KamilWuu/Line_Follower_ZACZ/README.md

# Line_Follower_ZACZ
LineFollower robot created with my friend Oliwier W. Robot is made as a project for a mobile robots course in the sixth semester of the automation and robotics program at the Wrocaw University of Science and Technology.
