KamilWuu/Line_Follower_ZACZ/zacz_QT/latex/mainwindow_8h.tex

\doxysection{/home/kamil/\+Documents/projects-\/repos/\+Line\+\_\+\+Follower\+\_\+\+ZACZ/zacz\+\_\+\+QT/mainwindow.h File Reference}
\hypertarget{mainwindow_8h}{}\label{mainwindow_8h}\index{/home/kamil/Documents/projects-\/repos/Line\_Follower\_ZACZ/zacz\_QT/mainwindow.h@{/home/kamil/Documents/projects-\/repos/Line\_Follower\_ZACZ/zacz\_QT/mainwindow.h}}

Plik nagłówkowy klasy \doxylink{classMainWindow}{Main\+Window}.  

{\ttfamily \#include $<$QMain\+Window$>$}\newline
{\ttfamily \#include $<$QDebug$>$}\newline
{\ttfamily \#include $<$QMessage\+Box$>$}\newline
{\ttfamily \#include $<$QString$>$}\newline
{\ttfamily \#include $<$QResize\+Event$>$}\newline
{\ttfamily \#include $<$QLabel$>$}\newline
{\ttfamily \#include $<$QList$>$}\newline
{\ttfamily \#include $<$QElapsed\+Timer$>$}\newline
{\ttfamily \#include $<$QTcp\+Socket$>$}\newline
{\ttfamily \#include $<$QTransform$>$}\newline
{\ttfamily \#include $<$QPixmap$>$}\newline
{\ttfamily \#include $<$QPainter$>$}\newline
{\ttfamily \#include $<$QPaint\+Event$>$}\newline
{\ttfamily \#include "{}plotwindow.\+h"{}}\newline
\doxysubsubsection*{Classes}
\begin{DoxyCompactItemize}
\item 
class \mbox{\hyperlink{classMainWindow}{Main\+Window}}
\begin{DoxyCompactList}\small\item\em Główne okno aplikacji. \end{DoxyCompactList}\end{DoxyCompactItemize}

\doxysubsection{Detailed Description}
Plik nagłówkowy klasy \doxylink{classMainWindow}{Main\+Window}.
