KamilWuu/Line_Follower_ZACZ/images/ae86.jpg

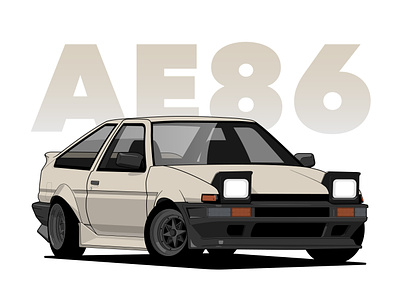
images/ae86.jpg
