KamilWuu/Line_Follower_ZACZ/images/ae862.jpg

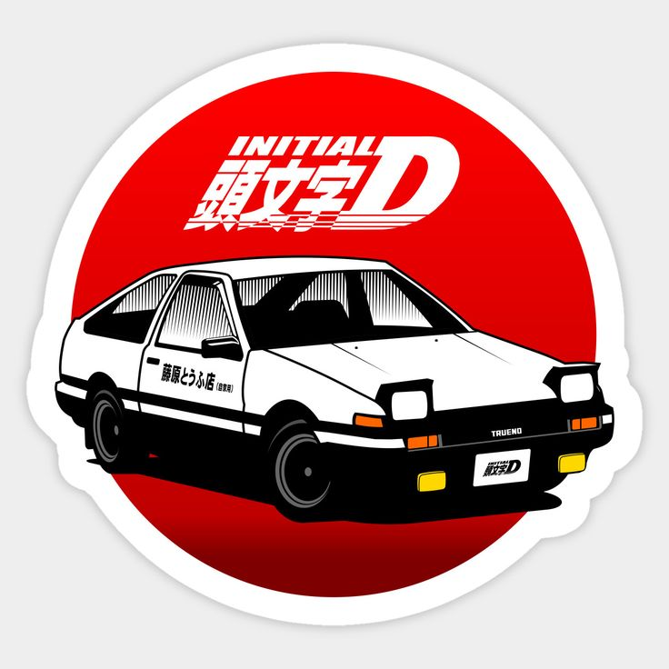
images/ae862.jpg
