KamilWuu/Line_Follower_ZACZ/images/ae863.jpg

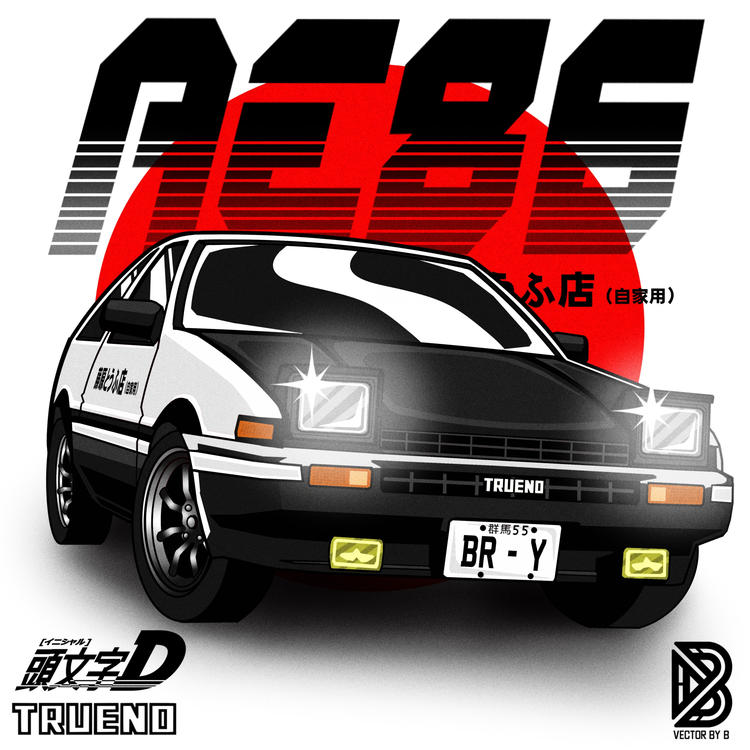
images/ae863.jpg
