KamilWuu/Line_Follower_ZACZ/zacz_QT/images/background.png

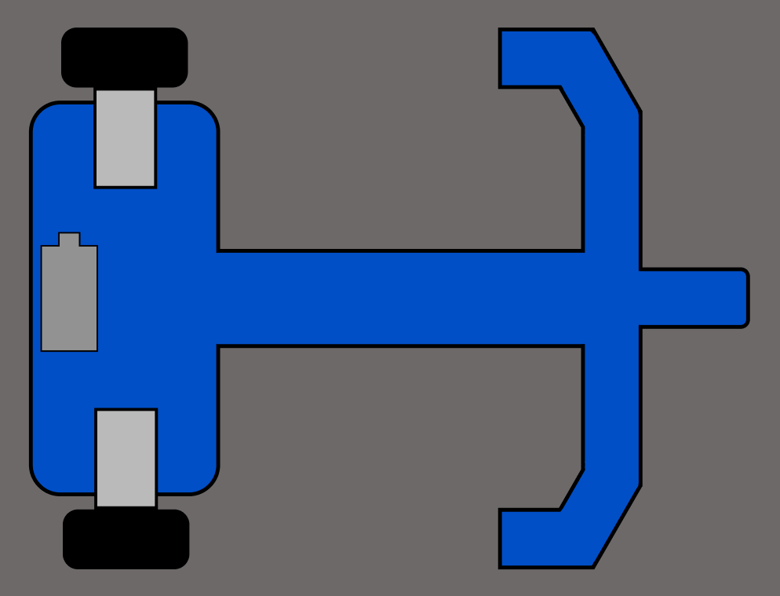
zacz_QT/images/background.png
