KamilWuu/Line_Follower_ZACZ/zacz_QT/images/kompas.png

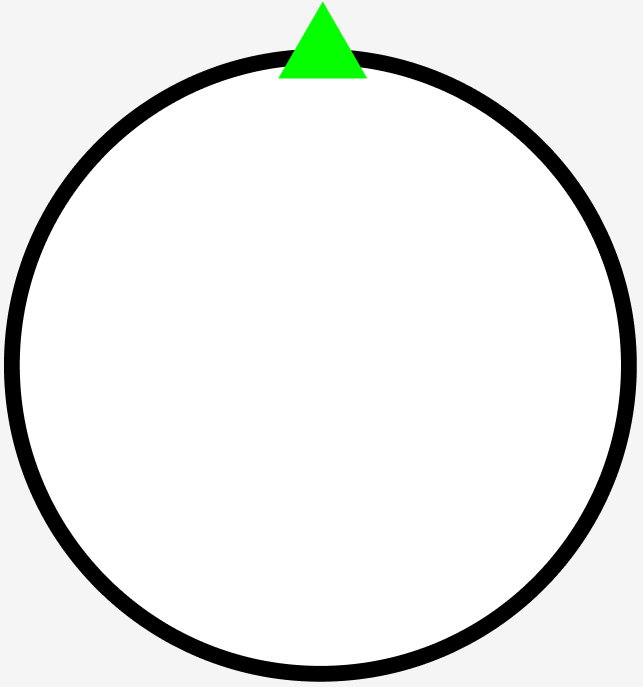
zacz_QT/images/kompas.png
