KamilWuu/Line_Follower_ZACZ/zacz_QT/images/main_background.png

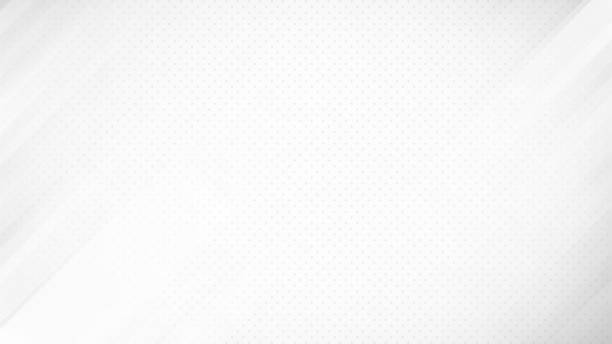
zacz_QT/images/main_background.png
