KamilWuu/Line_Follower_ZACZ/zacz_QT/images/robot_kompas.png

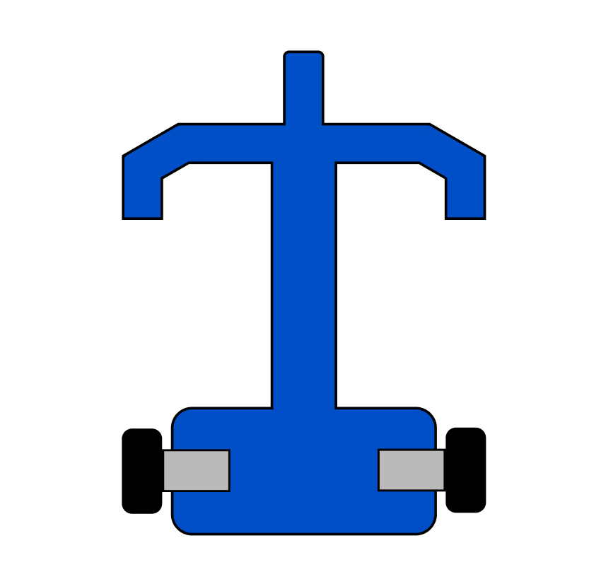
zacz_QT/images/robot_kompas.png
