KamilWuu/Line_Follower_ZACZ/images/main_board_v3.dxf

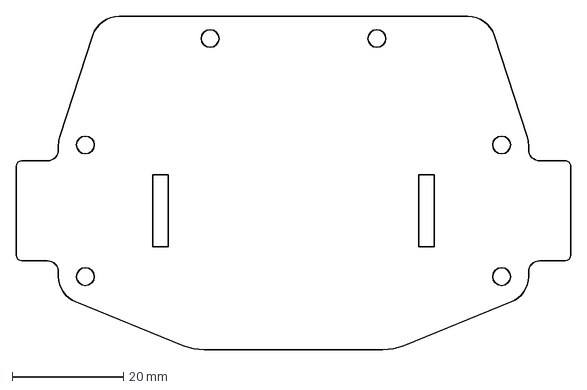
[picture p35: CAD file, 2024-04-28]
images/main_board_v3.dxf
99.8 x 60.0 mm
