KamilWuu/Line_Follower_ZACZ/images/main_board_limits.dxf

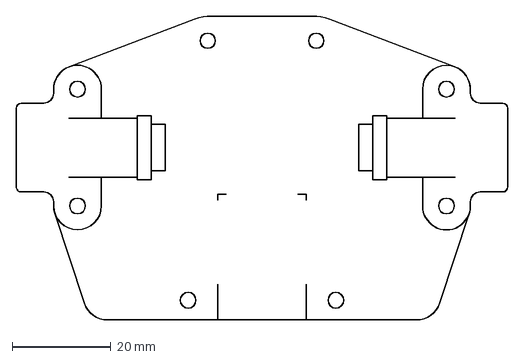
[picture p36: CAD file, 2024-04-28]
images/main_board_limits.dxf
99.8 x 61.7 mm
