KamilWuu/Line_Follower_ZACZ/mechanics/main_board.dxf

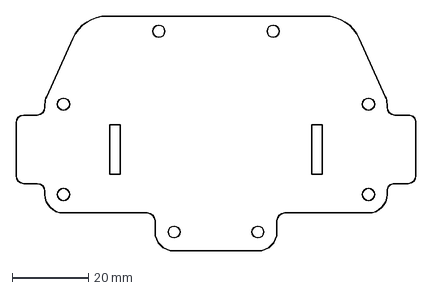
[picture p37: CAD file, 2024-04-23]
mechanics/main_board.dxf
105.0 x 61.7 mm
