KamilWuu/Line_Follower_ZACZ/electronics/Płytka główna/Płytka główna.step

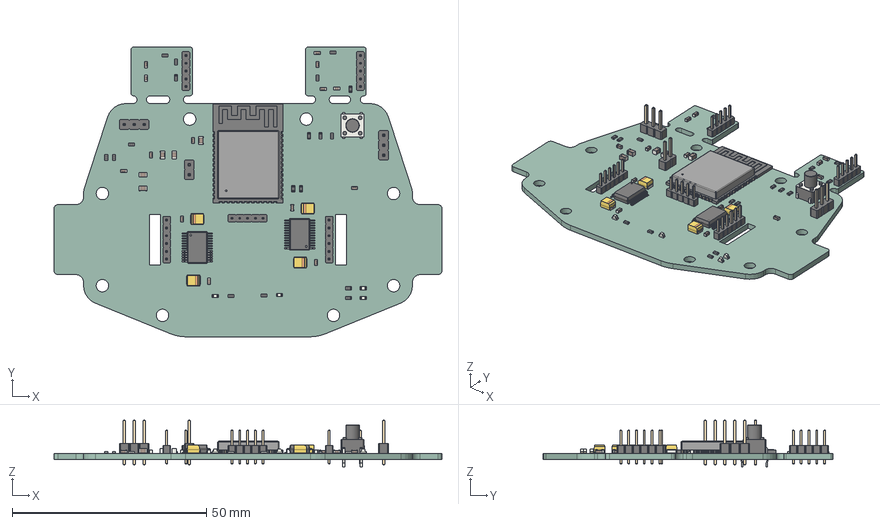
[picture p38: CAD file, 2024-06-22]
electronics/Płytka główna/Płytka główna.step
99.8 x 74.5 x 12.0 mm
LED_0603_1608Metric x 4
R_0603_1608Metric x 18
PinHeader_1x05_P200mm_Vertical x 3
ESP32-S3-WROOM-1
C_0603_1608Metric x 14
PinHeader_1x03_P254mm_Vertical x 2
CP_EIA_3528_21_Kemet_B x 4
C_0805_2012Metric x 5
PinHeader_1x06_P200mm_Vertical x 2
SSOP_24_53x82mm_P065mm x 2
PinHeader_1x02_P254mm_Vertical
SW_PUSH_6mm_h7.3mm
PÅytka gÅÃ³wna_PCB
