KamilWuu/Line_Follower_ZACZ/mechanics/Płytka z czujnikami.step

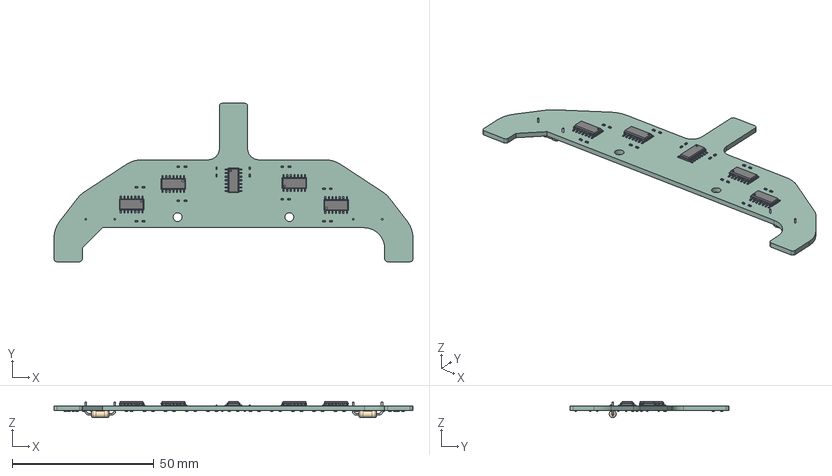
[picture p39: CAD file, 2024-06-22]
mechanics/Płytka z czujnikami.step
126.8 x 56.0 x 5.75 mm
R_0402_1005Metric x 60
CQ assembly x 5
R_Axial_DIN0207_L63mm_D25mm_P1016mm_Horizontal x 2
PÅytka z czujnikami_PCB
