KamilWuu/Line_Follower_ZACZ/images/plytka_glowna.dxf

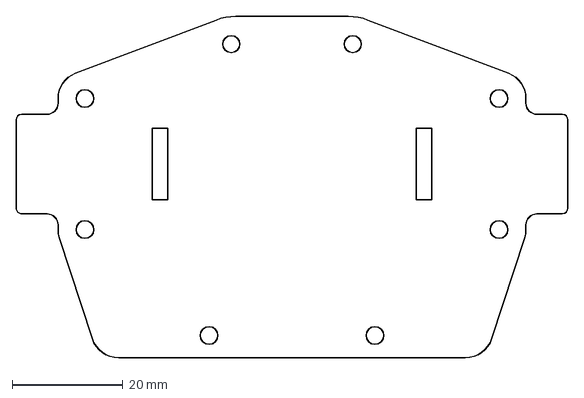
[picture p40: CAD file, 2024-04-24]
images/plytka_glowna.dxf
99.8 x 61.7 mm
