KamilWuu/Line_Follower_ZACZ/mechanics/sensor_board_V2.0.dxf

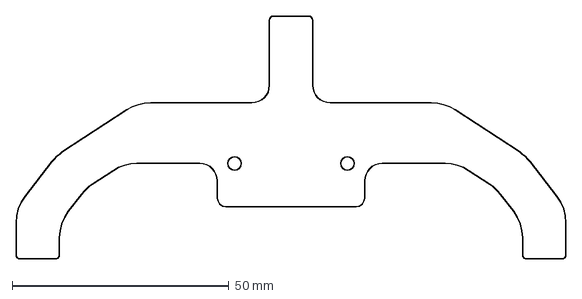
[picture p41: CAD file, 2024-04-29]
mechanics/sensor_board_V2.0.dxf
126.9 x 56.0 mm
