KamilWuu/Line_Follower_ZACZ/images/plytka_z_czujnikami.dxf

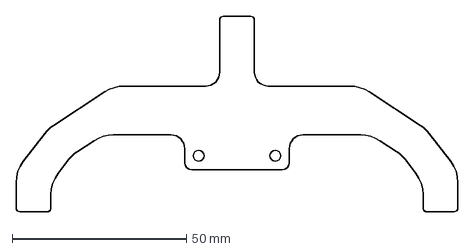
[picture p42: CAD file, 2024-04-24]
images/plytka_z_czujnikami.dxf
126.9 x 56.0 mm
