KamilWuu/Line_Follower_ZACZ/images/back_PCB_draw.dxf

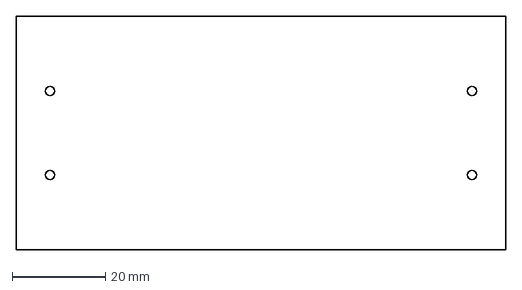
[picture p43: CAD file, 2024-03-31]
images/back_PCB_draw.dxf
105.0 x 50.0 mm
