KamilWuu/Line_Follower_ZACZ/mechanics/N20_Bracket_Extended_Pololu.stp

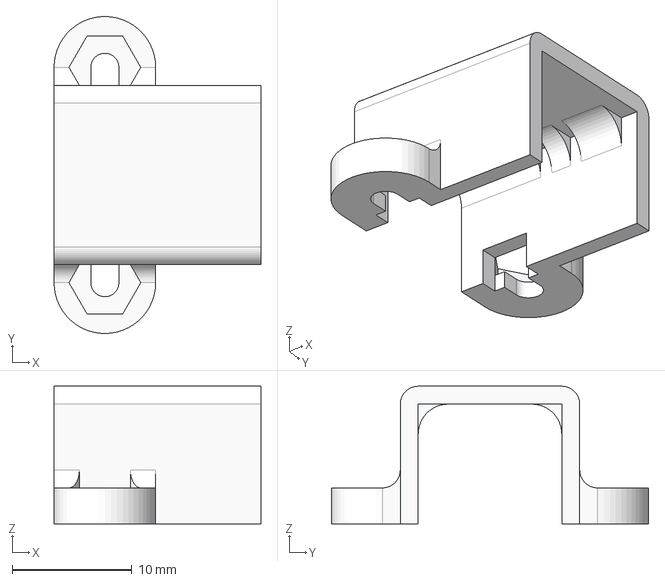
[picture p44: CAD file, 2024-04-23]
mechanics/N20_Bracket_Extended_Pololu.stp
17.3 x 26.5 x 11.5 mm
