KamilWuu/Line_Follower_ZACZ/mechanics/n20_bracket.step

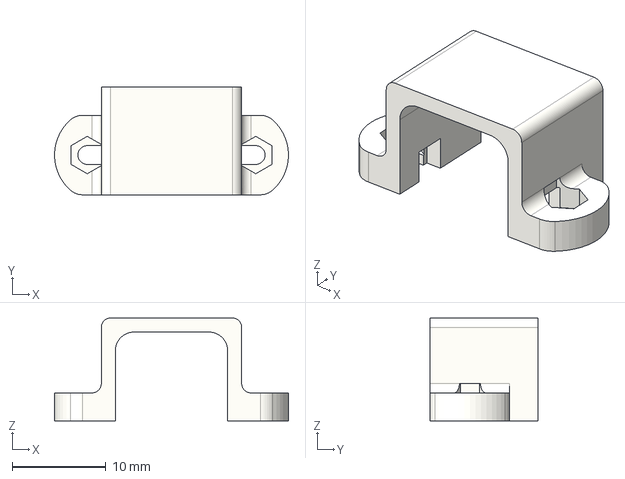
[picture p45: CAD file, 2024-03-31]
mechanics/n20_bracket.step
25.0 x 11.5 x 11.0 mm
