KamilWuu/Line_Follower_ZACZ/mechanics/sensor_board.dxf

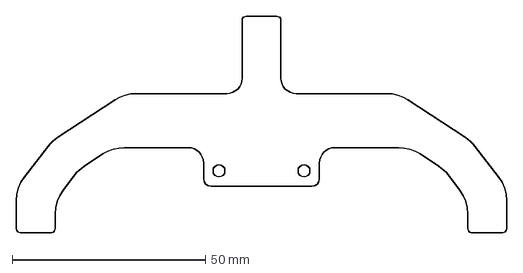
[picture p46: CAD file, 2024-04-27, an earlier design]
mechanics/sensor_board.dxf
126.9 x 56.0 mm
