KamilWuu/Line_Follower_ZACZ/(list of files, cad)

Other CAD files:
mechanics/Płytka główna.step
mechanics/A4.ipt
mechanics/ESP32-S3-WROOM-1.ipt
mechanics/LF.iam
mechanics/LF_2.iam
mechanics/N20_Bracket_Extended_Pololu.ipt
mechanics/OldVersions/LF_2.0014.iam
mechanics/OldVersions/N20_Bracket_Extended_Pololu.0002.ipt
mechanics/OldVersions/dol_trzymacz.0001.ipt
mechanics/OldVersions/lacznik.0005.ipt
mechanics/OldVersions/lacznik_2.0002.ipt
mechanics/OldVersions/li-pol_250.0001.ipt
mechanics/OldVersions/mocowanie.0001.ipt
mechanics/OldVersions/plytka_glowna.0005.ipt
mechanics/OldVersions/plytka_glowna_v3.0001.ipt
mechanics/OldVersions/przód V2.0.0001.ipt
mechanics/OldVersions/przód.0004.ipt
mechanics/OldVersions/ty.0006.ipt
mechanics/QRE1113GR.ipt
mechanics/belka.ipt
mechanics/dol_trzymacz.ipt
mechanics/kolko.ipt
mechanics/lacznik.ipt
mechanics/lacznik_2.ipt
mechanics/li-pol_250.ipt
mechanics/li-pol_520.ipt
mechanics/mocowanie.ipt
mechanics/n20_bracket.ipt
mechanics/plytka_glowna.ipt
mechanics/plytka_glowna_v3.ipt
mechanics/przód V2.0.ipt
mechanics/przód.ipt
mechanics/trzymacz.ipt
mechanics/ty.ipt
