KamilWuu/Line_Follower_ZACZ/documents/Etap 2/Płytka główna.pdf

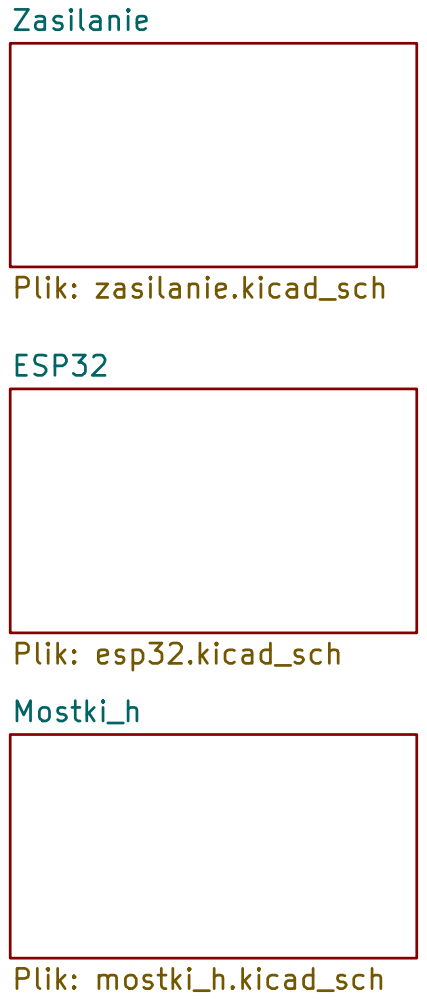
[picture p47: page 1]

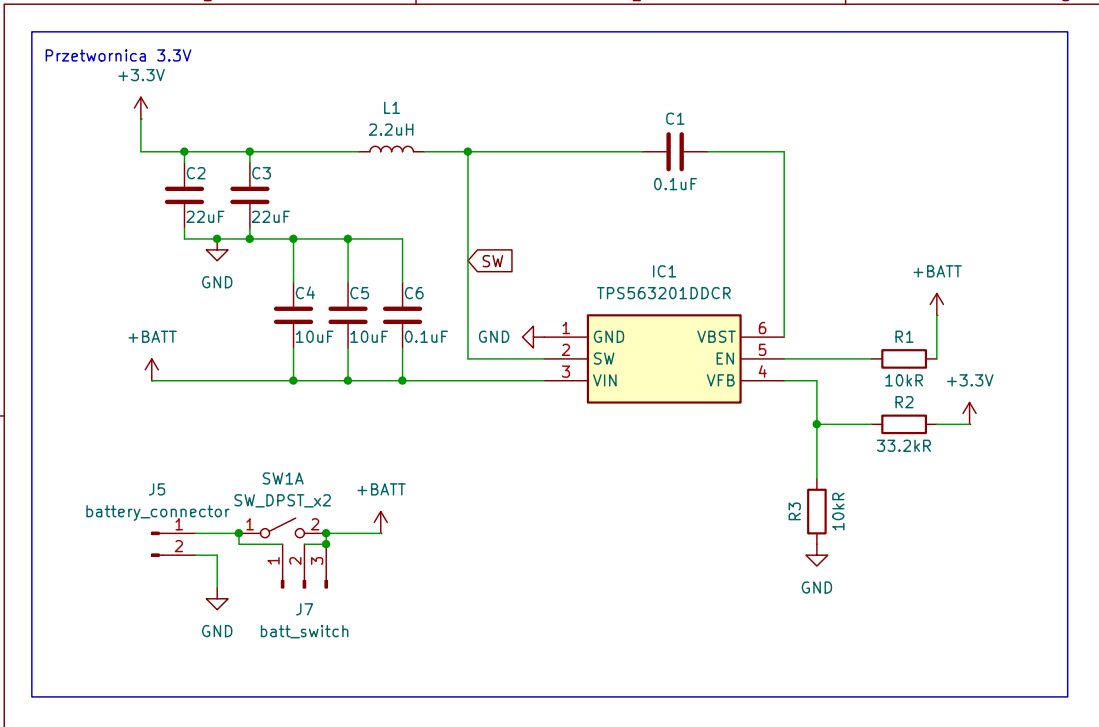
[picture p48: page 2]

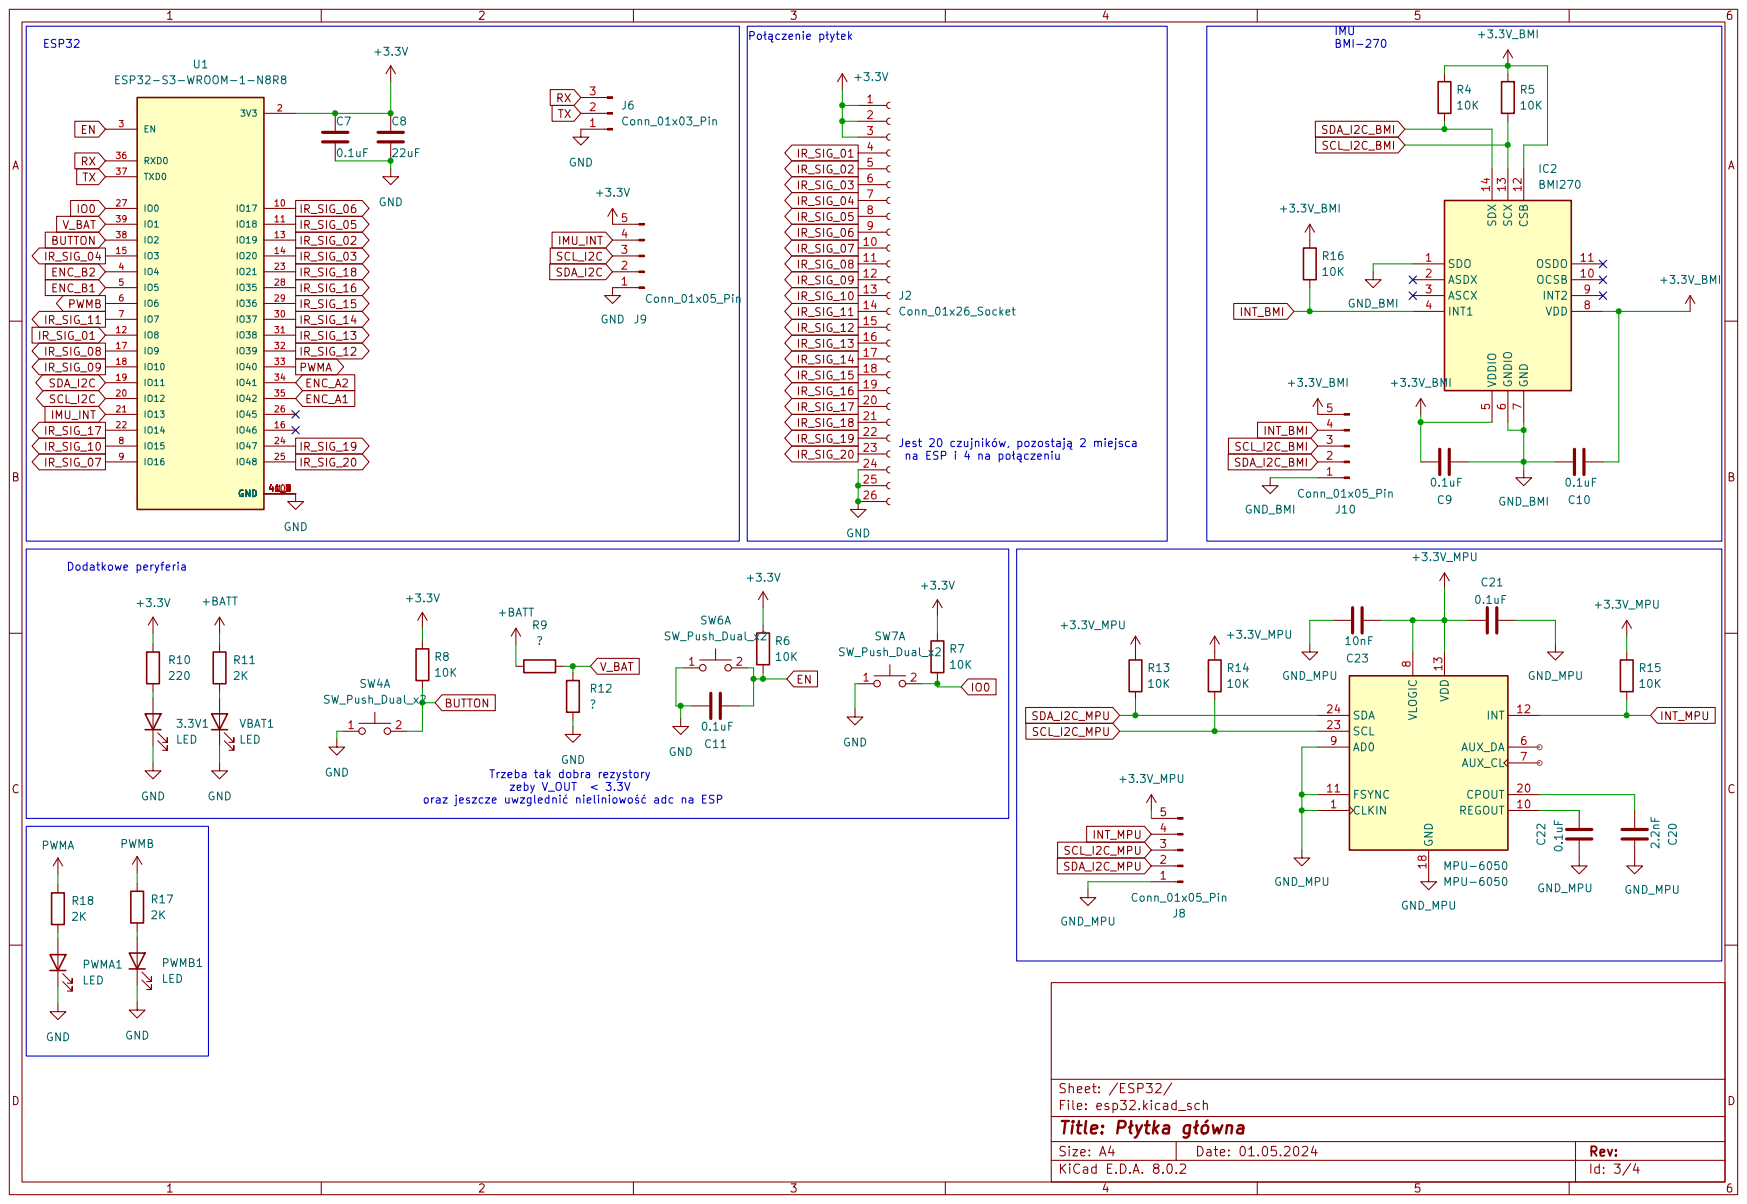
[picture p49: page 3]

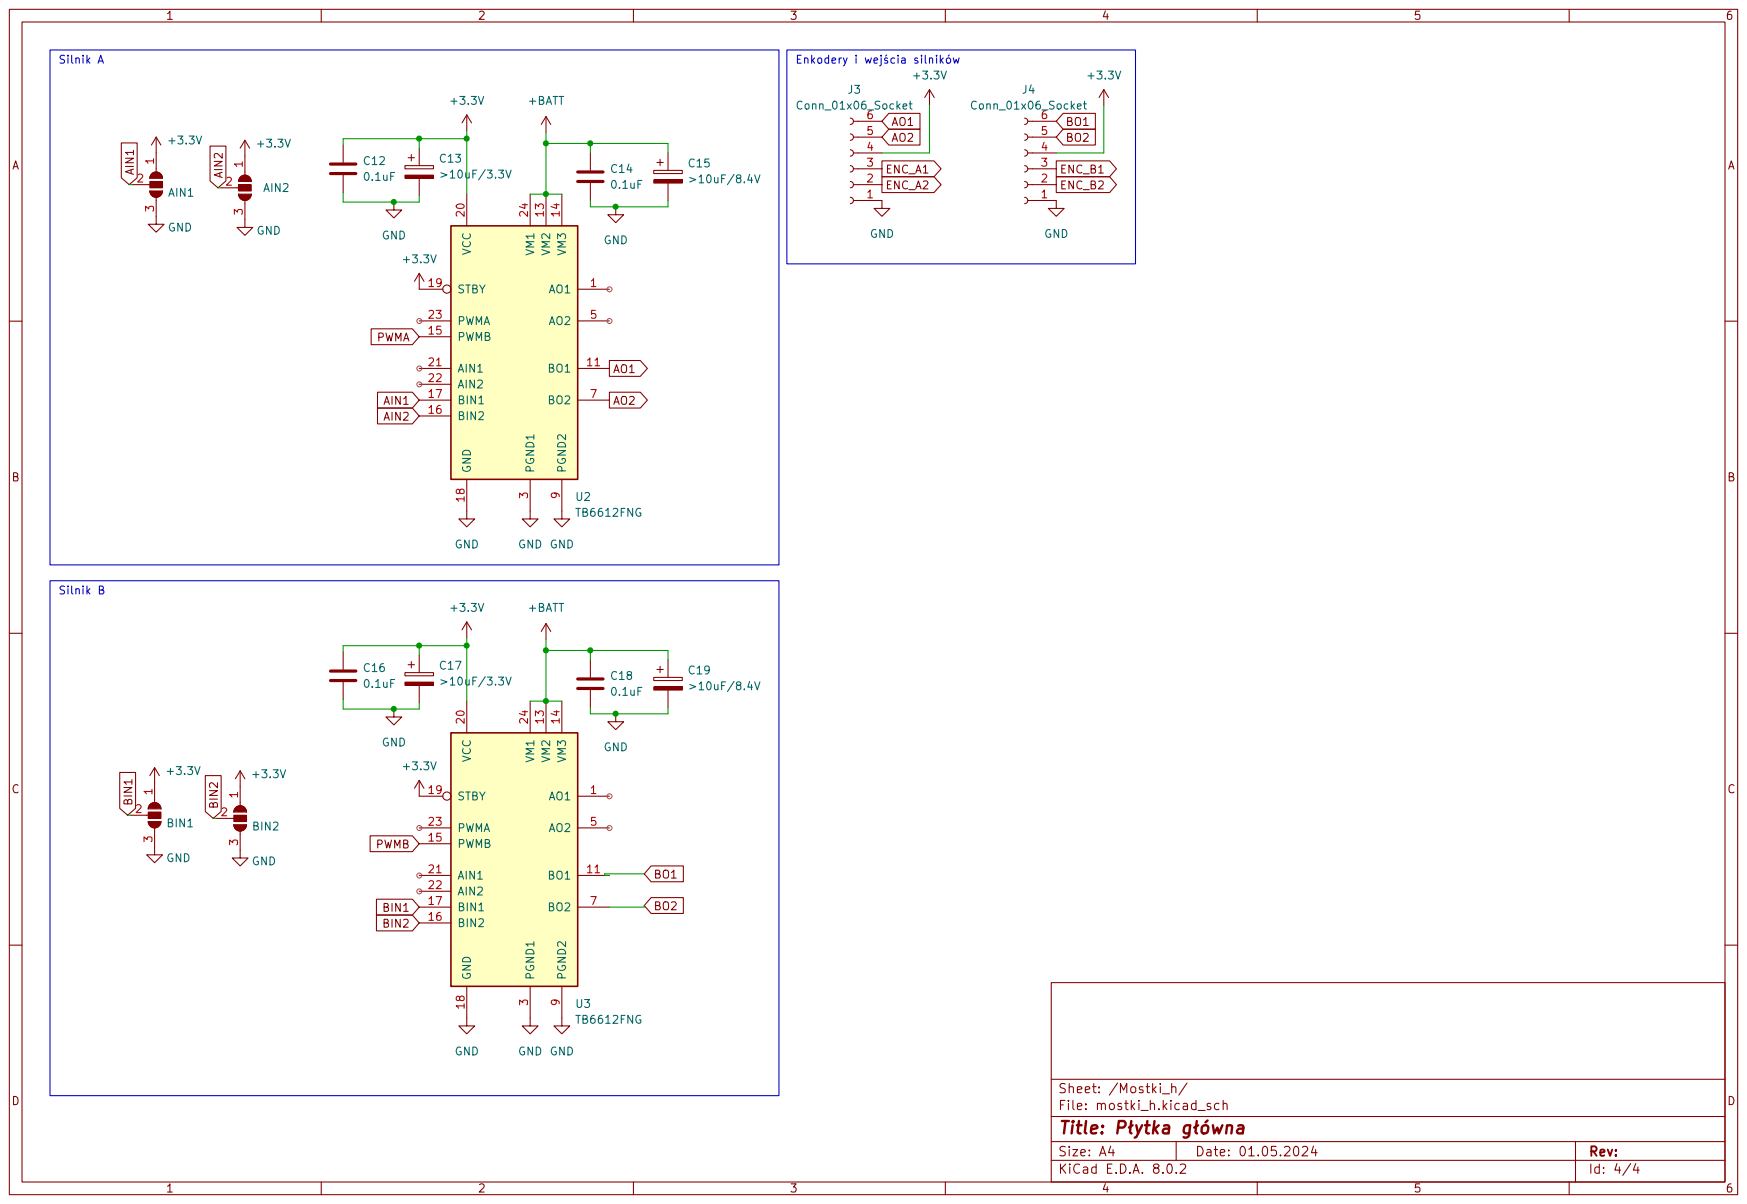
[picture p50: page 4]
