KamilWuu/Line_Follower_ZACZ/documents/Etap 2/Płytka główna_brd.pdf

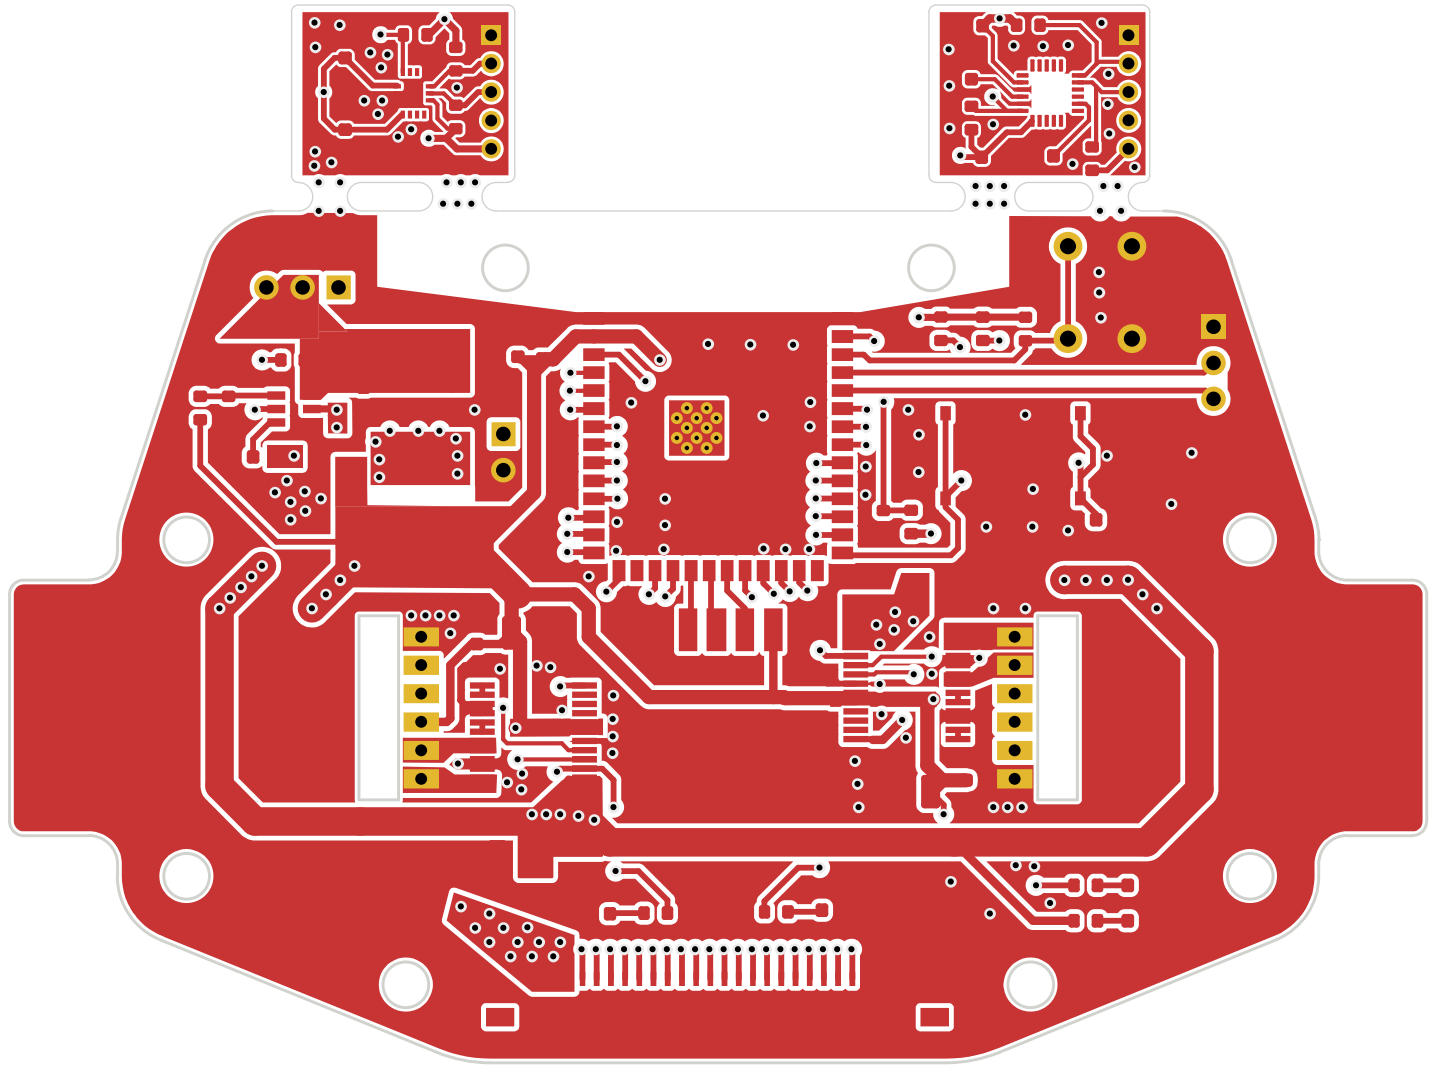
[picture p51: page 1]

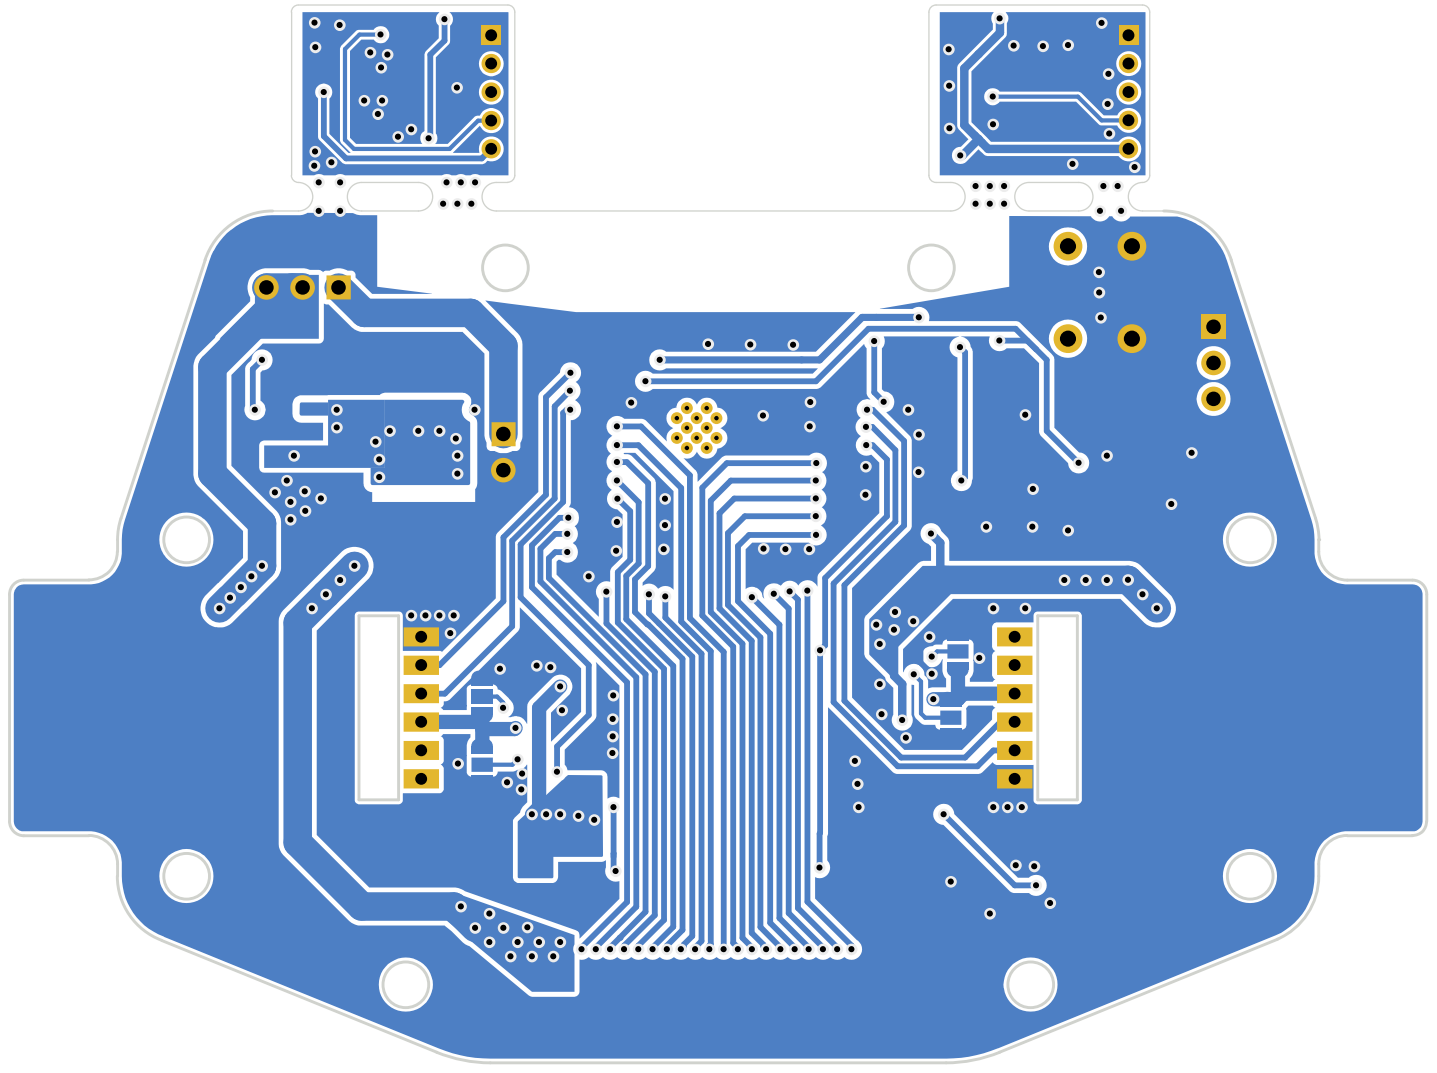
[picture p52: page 2]
