KamilWuu/Line_Follower_ZACZ/documents/Etap 2/Płytka z czujnikami.pdf

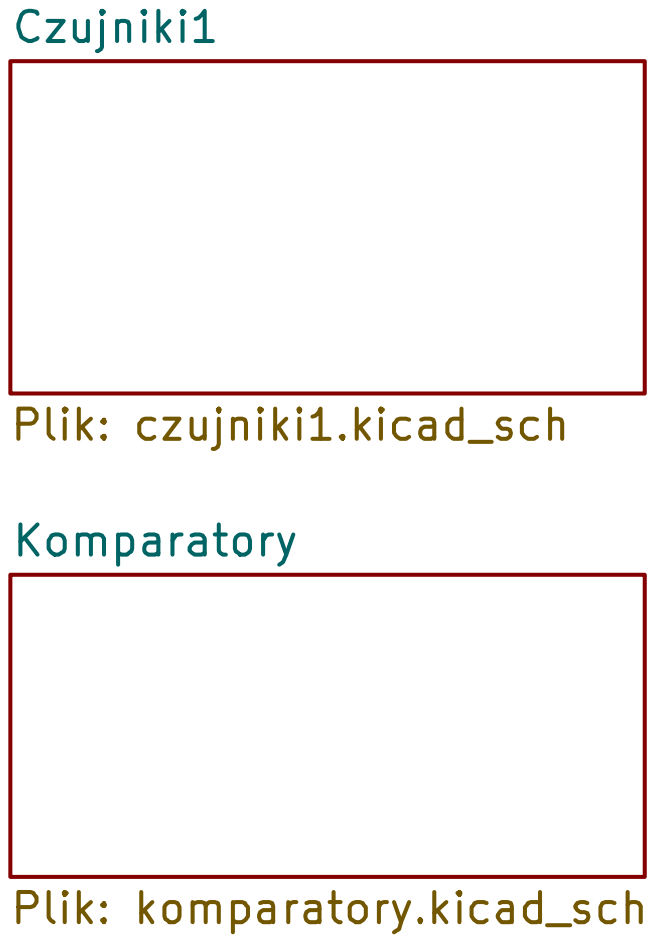
[picture p53: page 1]

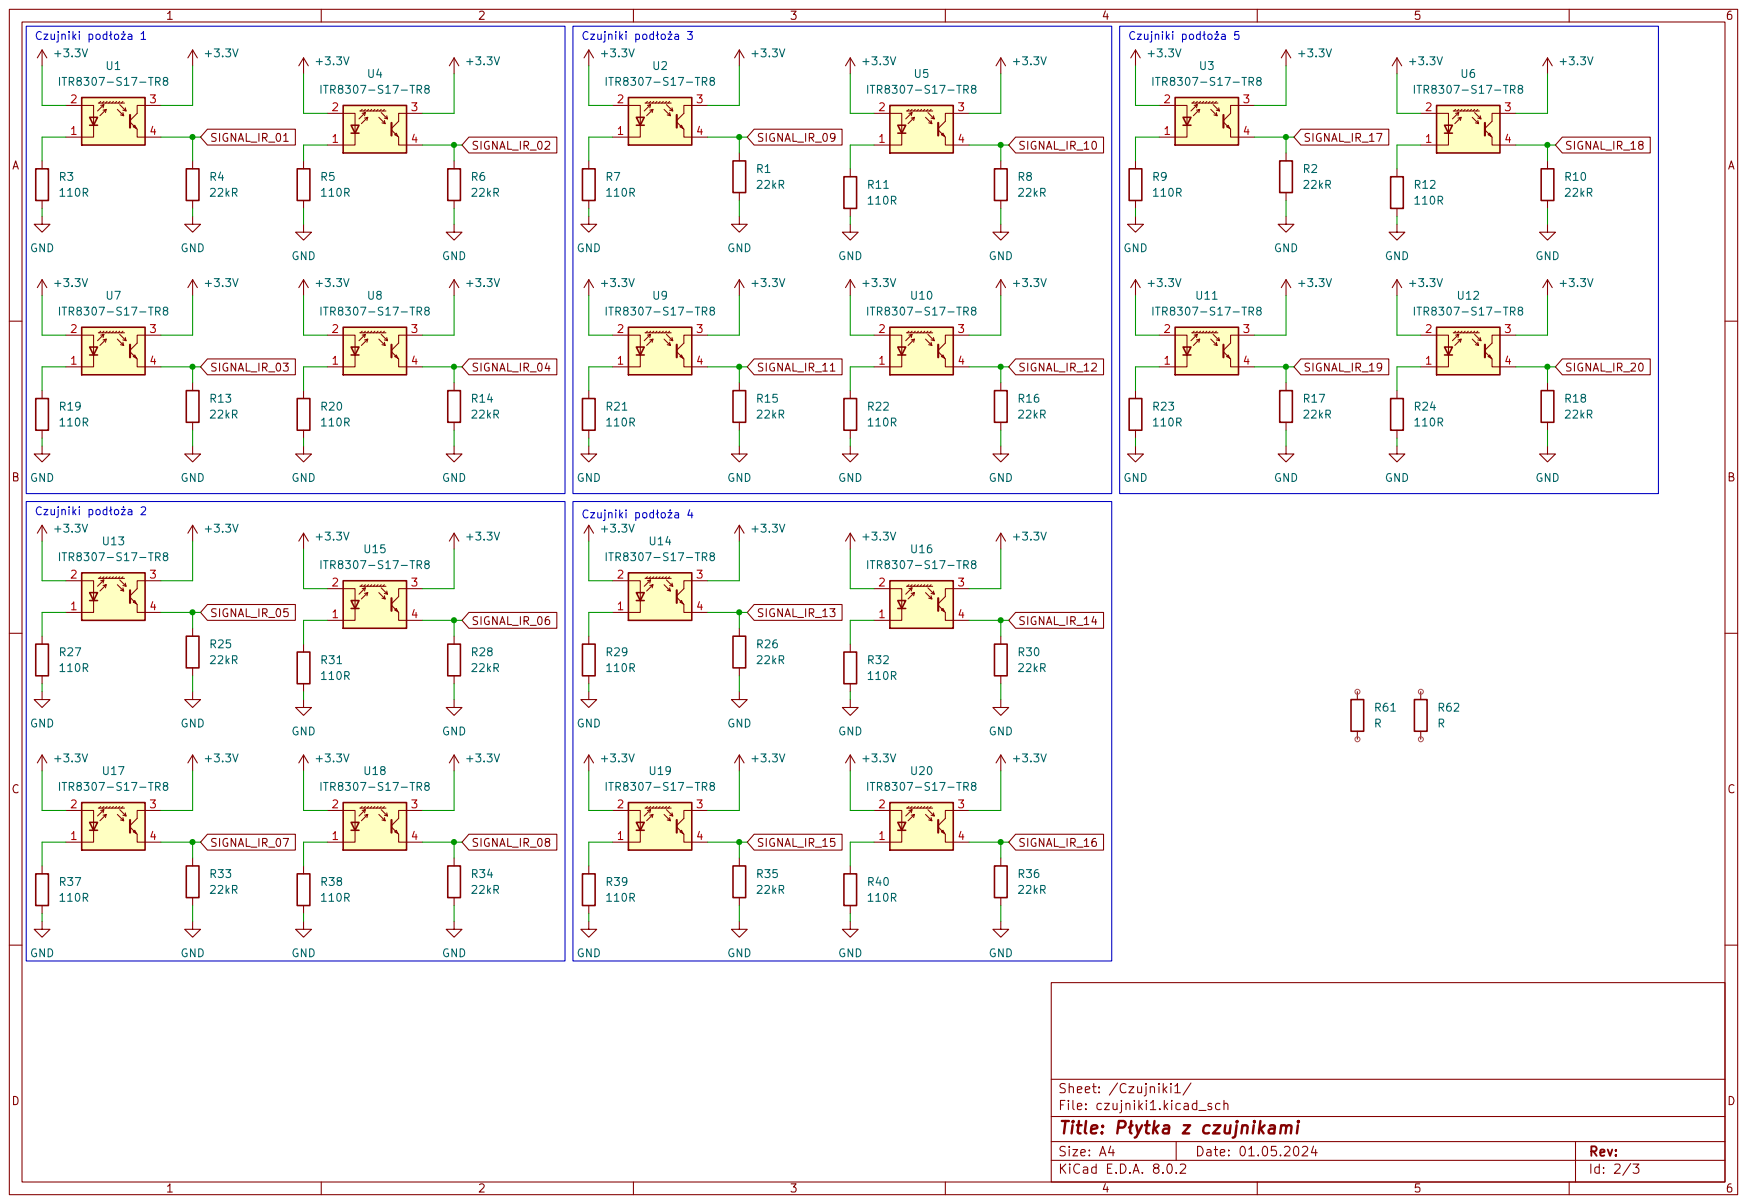
[picture p54: page 2]

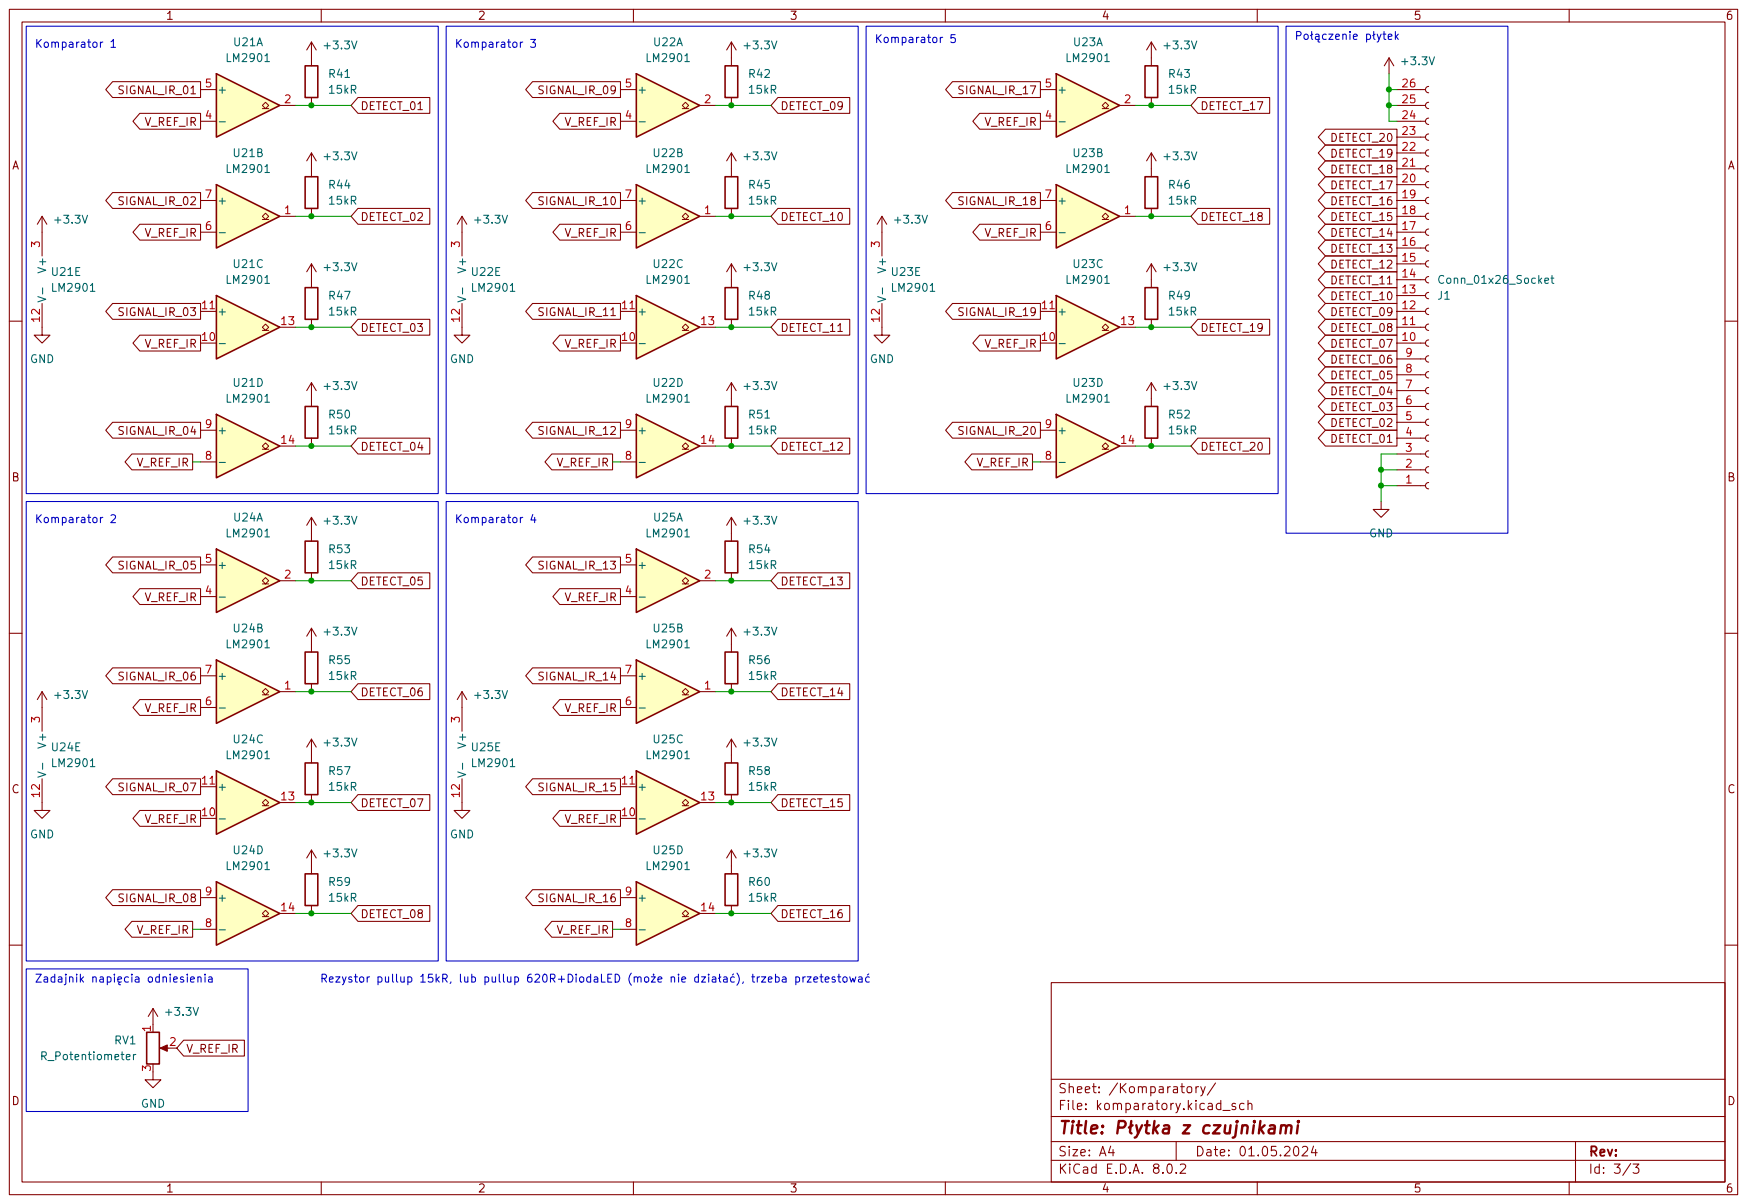
[picture p55: page 3]
