KamilWuu/Line_Follower_ZACZ/documents/Etap 2/Płytka z czujnikami_brd.pdf

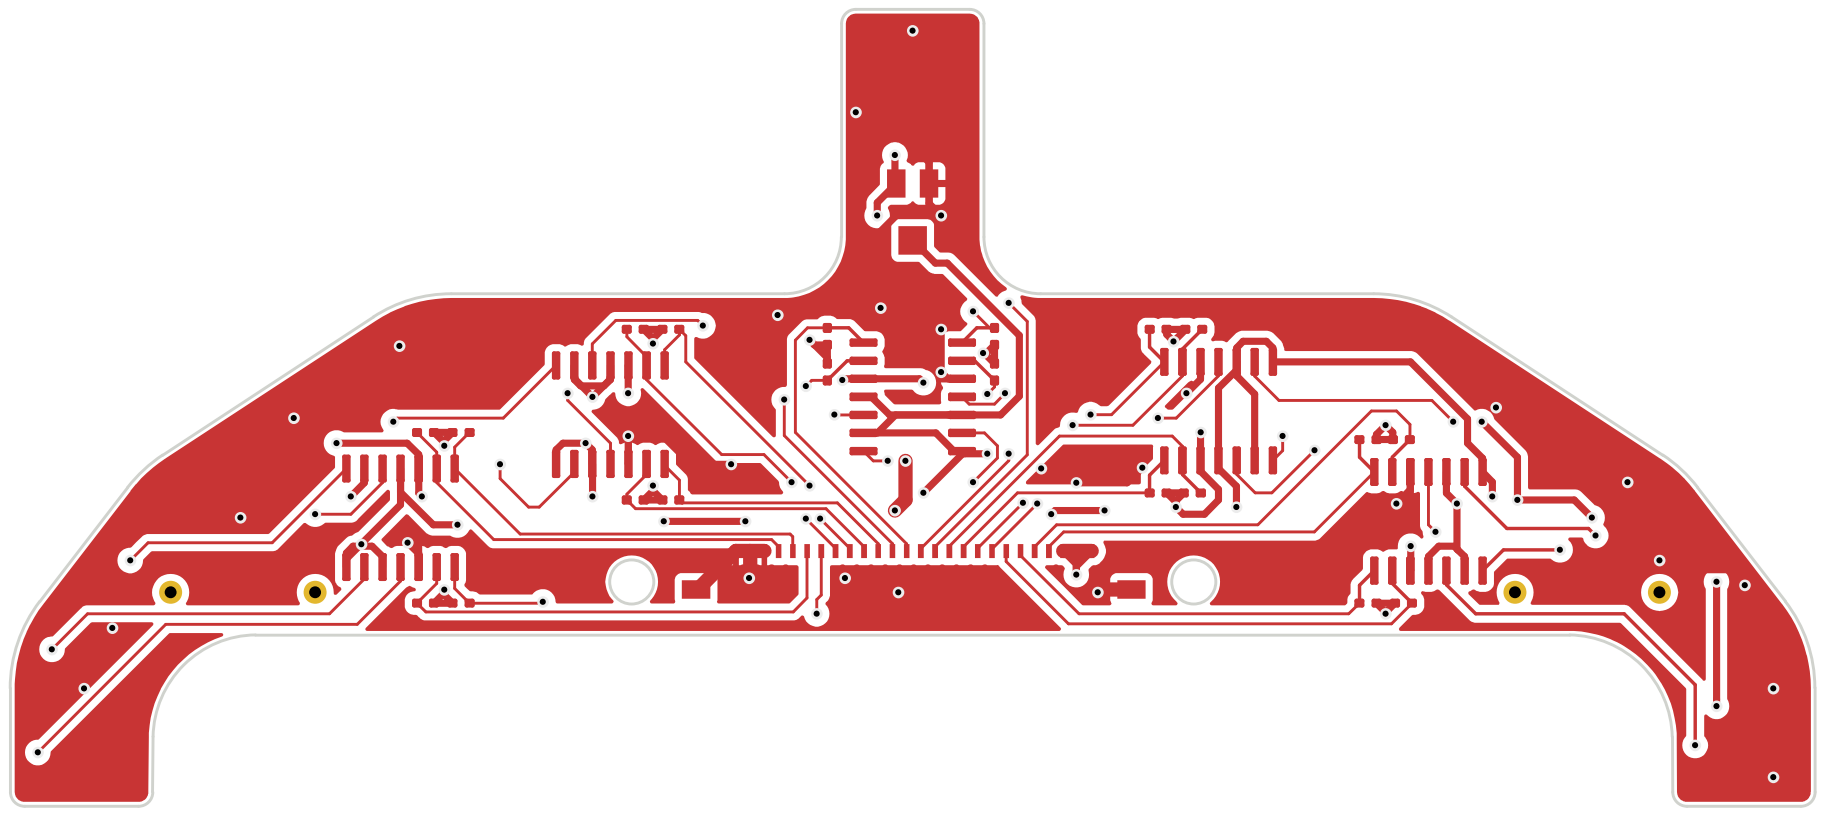
[picture p56: page 1]

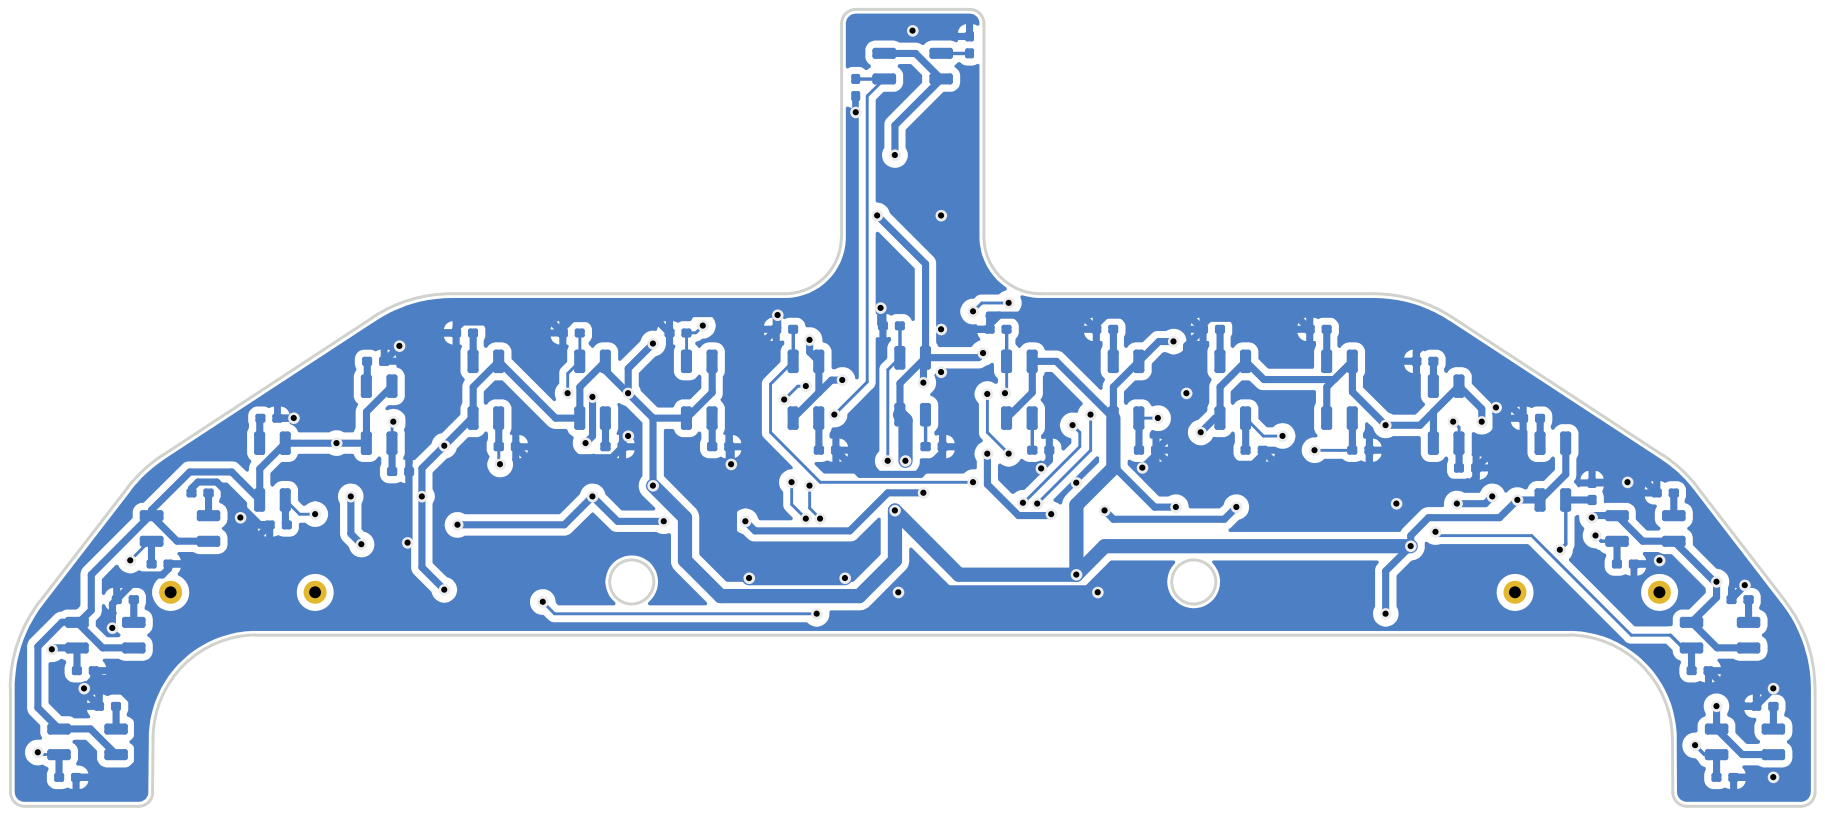
[picture p57: page 2]
