KamilWuu/Line_Follower_ZACZ/electronics/Płytka z czujnikami/Płytka z czujnikami.kicad_pcb

## KiCad design electronics/Płytka z czujnikami/Płytka z czujnikami.kicad_pcb (2024-06-22)

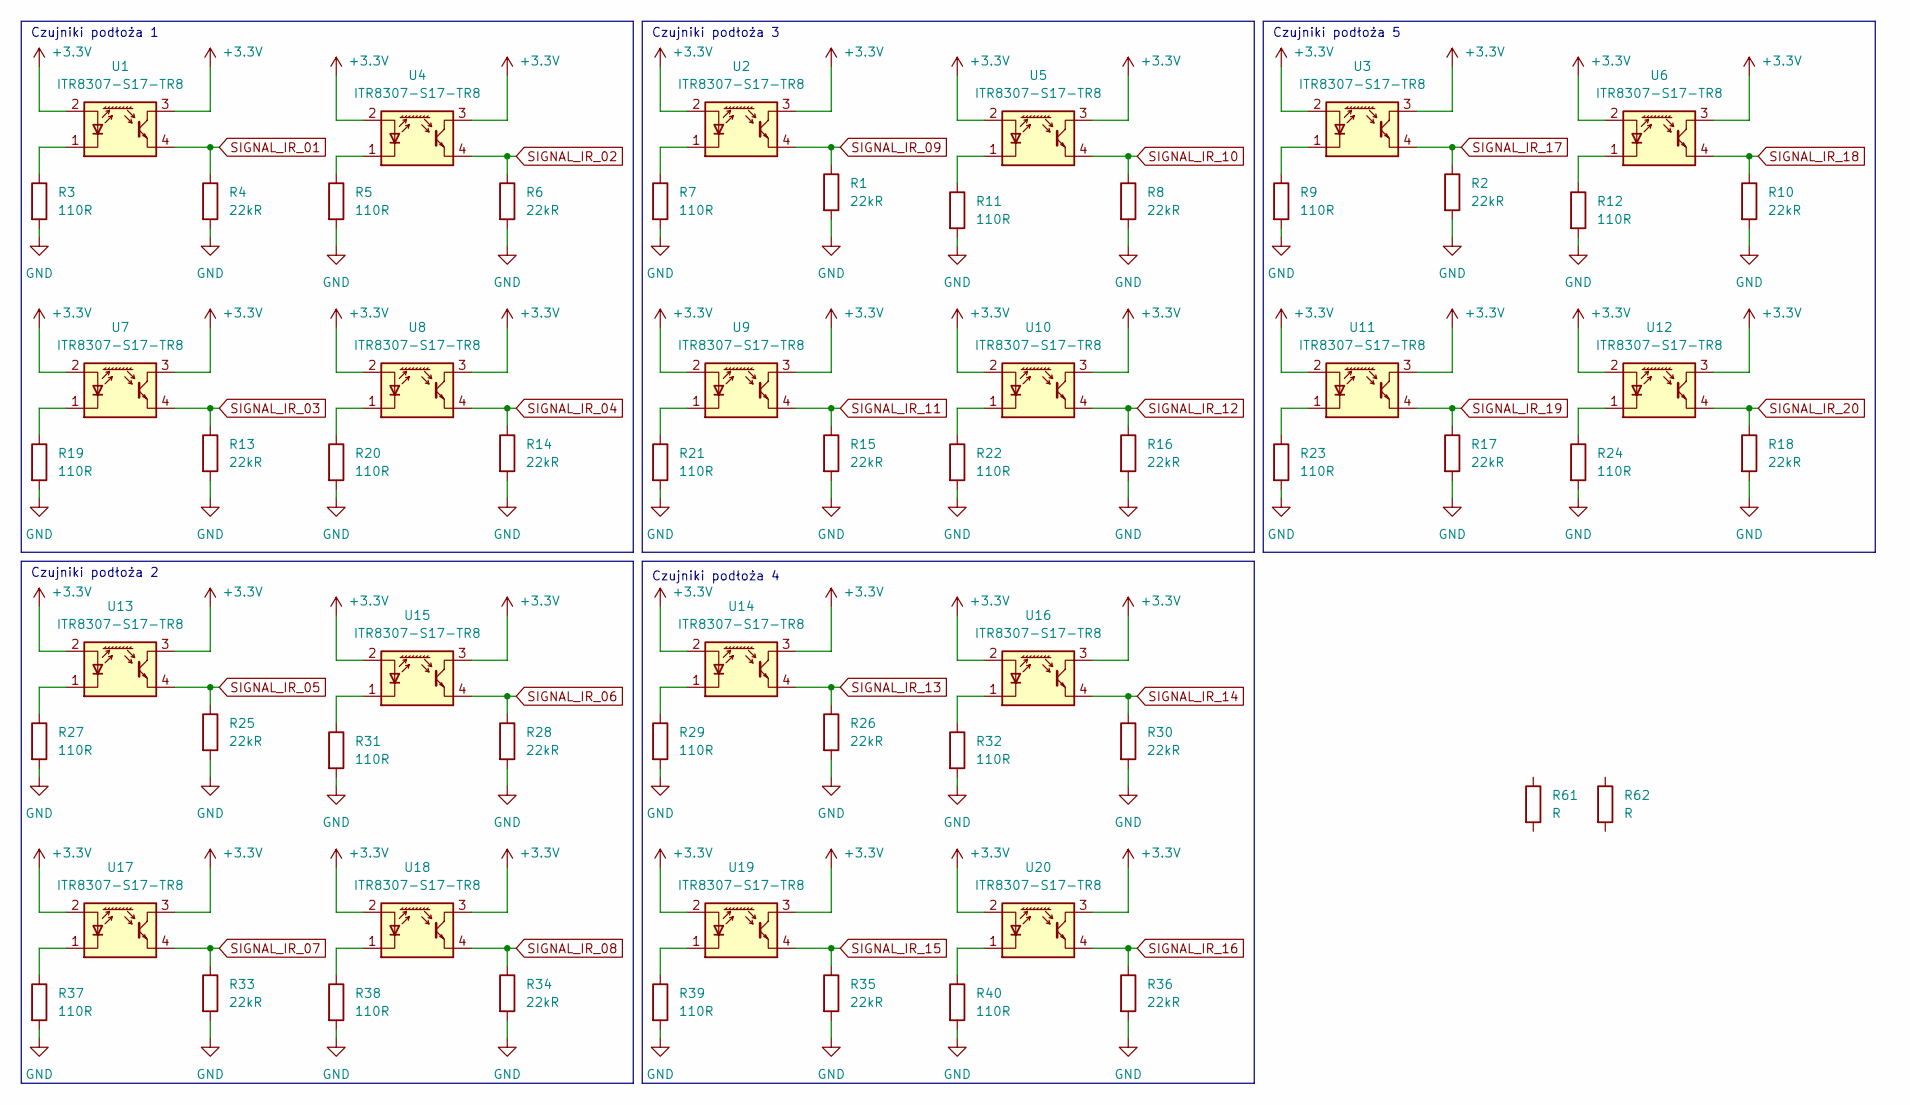
[picture p58: schematic czujniki1.kicad_sch, Płytka z czujnikami]

Parts:
R1, R2, R4, R6, R8, R10, R13, R14, R15, R16, R17, R18, R25, R26, R28, R30, R33, R34, R35, R36: 22kR; R_0402_1005Metric_Pad0.72x0.64mm_HandSolder
R3, R5, R7, R9, R11, R12, R19, R20, R21, R22, R23, R24, R27, R29, R31, R32, R37, R38, R39, R40: 110R; R_0402_1005Metric_Pad0.72x0.64mm_HandSolder
R61, R62: R; R_Axial_DIN0207_L6.3mm_D2.5mm_P10.16mm_Horizontal
U1, U2, U3, U4, U5, U6, U7, U8, U9, U10, U11, U12, U13, U14, U15, U16, U17, U18, U19, U20: ITR8307-S17-TR8; Everlight_ITR1201SR10AR

Connections:
+3.3V: U1.2 (A), U1.3, U2.2 (A), U2.3, U3.2 (A), U3.3, U4.2 (A), U4.3, U5.2 (A), U5.3, U6.2 (A), U6.3, U7.2 (A), U7.3, U8.2 (A), U8.3, U9.2 (A), U9.3, U10.2 (A), U10.3, U11.2 (A), U11.3, U12.2 (A), U12.3, U13.2 (A), U13.3, U14.2 (A), U14.3, U15.2 (A), U15.3, U16.2 (A), U16.3, U17.2 (A), U17.3, U18.2 (A), U18.3, U19.2 (A), U19.3, U20.2 (A), U20.3; also elsewhere on the board
GND: R1.2, R2.2, R3.2, R4.2, R5.2, R6.2, R7.2, R8.2, R9.2, R10.2, R11.2, R12.2, R13.2, R14.2, R15.2, R16.2, R17.2, R18.2, R19.2, R20.2, R21.2, R22.2, R23.2, R24.2, R25.2, R26.2, R27.2, R28.2, R29.2, R30.2, R31.2, R32.2, R33.2, R34.2, R35.2, R36.2, R37.2, R38.2, R39.2, R40.2; also elsewhere on the board
unnamed: R3.1, U1.1 (K)
unnamed: R7.1, U2.1 (K)
unnamed: R9.1, U3.1 (K)
unnamed: R5.1, U4.1 (K)
unnamed: R11.1, U5.1 (K)
unnamed: R12.1, U6.1 (K)
unnamed: R19.1, U7.1 (K)
unnamed: R20.1, U8.1 (K)
unnamed: R21.1, U9.1 (K)
unnamed: R22.1, U10.1 (K)
unnamed: R23.1, U11.1 (K)
unnamed: R24.1, U12.1 (K)
unnamed: R27.1, U13.1 (K)
unnamed: R29.1, U14.1 (K)
unnamed: R31.1, U15.1 (K)
unnamed: R32.1, U16.1 (K)
unnamed: R37.1, U17.1 (K)
unnamed: R38.1, U18.1 (K)
unnamed: R39.1, U19.1 (K)
unnamed: R40.1, U20.1 (K)
SIGNAL_IR_01: R4.1, U1.4; also elsewhere on the board
SIGNAL_IR_02: R6.1, U4.4; also elsewhere on the board
SIGNAL_IR_03: R13.1, U7.4; also elsewhere on the board
SIGNAL_IR_04: R14.1, U8.4; also elsewhere on the board
SIGNAL_IR_05: R25.1, U13.4; also elsewhere on the board
SIGNAL_IR_06: R28.1, U15.4; also elsewhere on the board
SIGNAL_IR_07: R33.1, U17.4; also elsewhere on the board
SIGNAL_IR_08: R34.1, U18.4; also elsewhere on the board
SIGNAL_IR_09: R1.1, U2.4; also elsewhere on the board
SIGNAL_IR_10: R8.1, U5.4; also elsewhere on the board
SIGNAL_IR_11: R15.1, U9.4; also elsewhere on the board
SIGNAL_IR_12: R16.1, U10.4; also elsewhere on the board
SIGNAL_IR_13: R26.1, U14.4; also elsewhere on the board
SIGNAL_IR_14: R30.1, U16.4; also elsewhere on the board
SIGNAL_IR_15: R35.1, U19.4; also elsewhere on the board
SIGNAL_IR_16: R36.1, U20.4; also elsewhere on the board
SIGNAL_IR_17: R2.1, U3.4; also elsewhere on the board
SIGNAL_IR_18: R10.1, U6.4; also elsewhere on the board
SIGNAL_IR_19: R17.1, U11.4; also elsewhere on the board
SIGNAL_IR_20: R18.1, U12.4; also elsewhere on the board

Notes on the sheet:
Czujniki podłoża 2
Czujniki podłoża 4
Czujniki podłoża 5
Czujniki podłoża 1
Czujniki podłoża 3

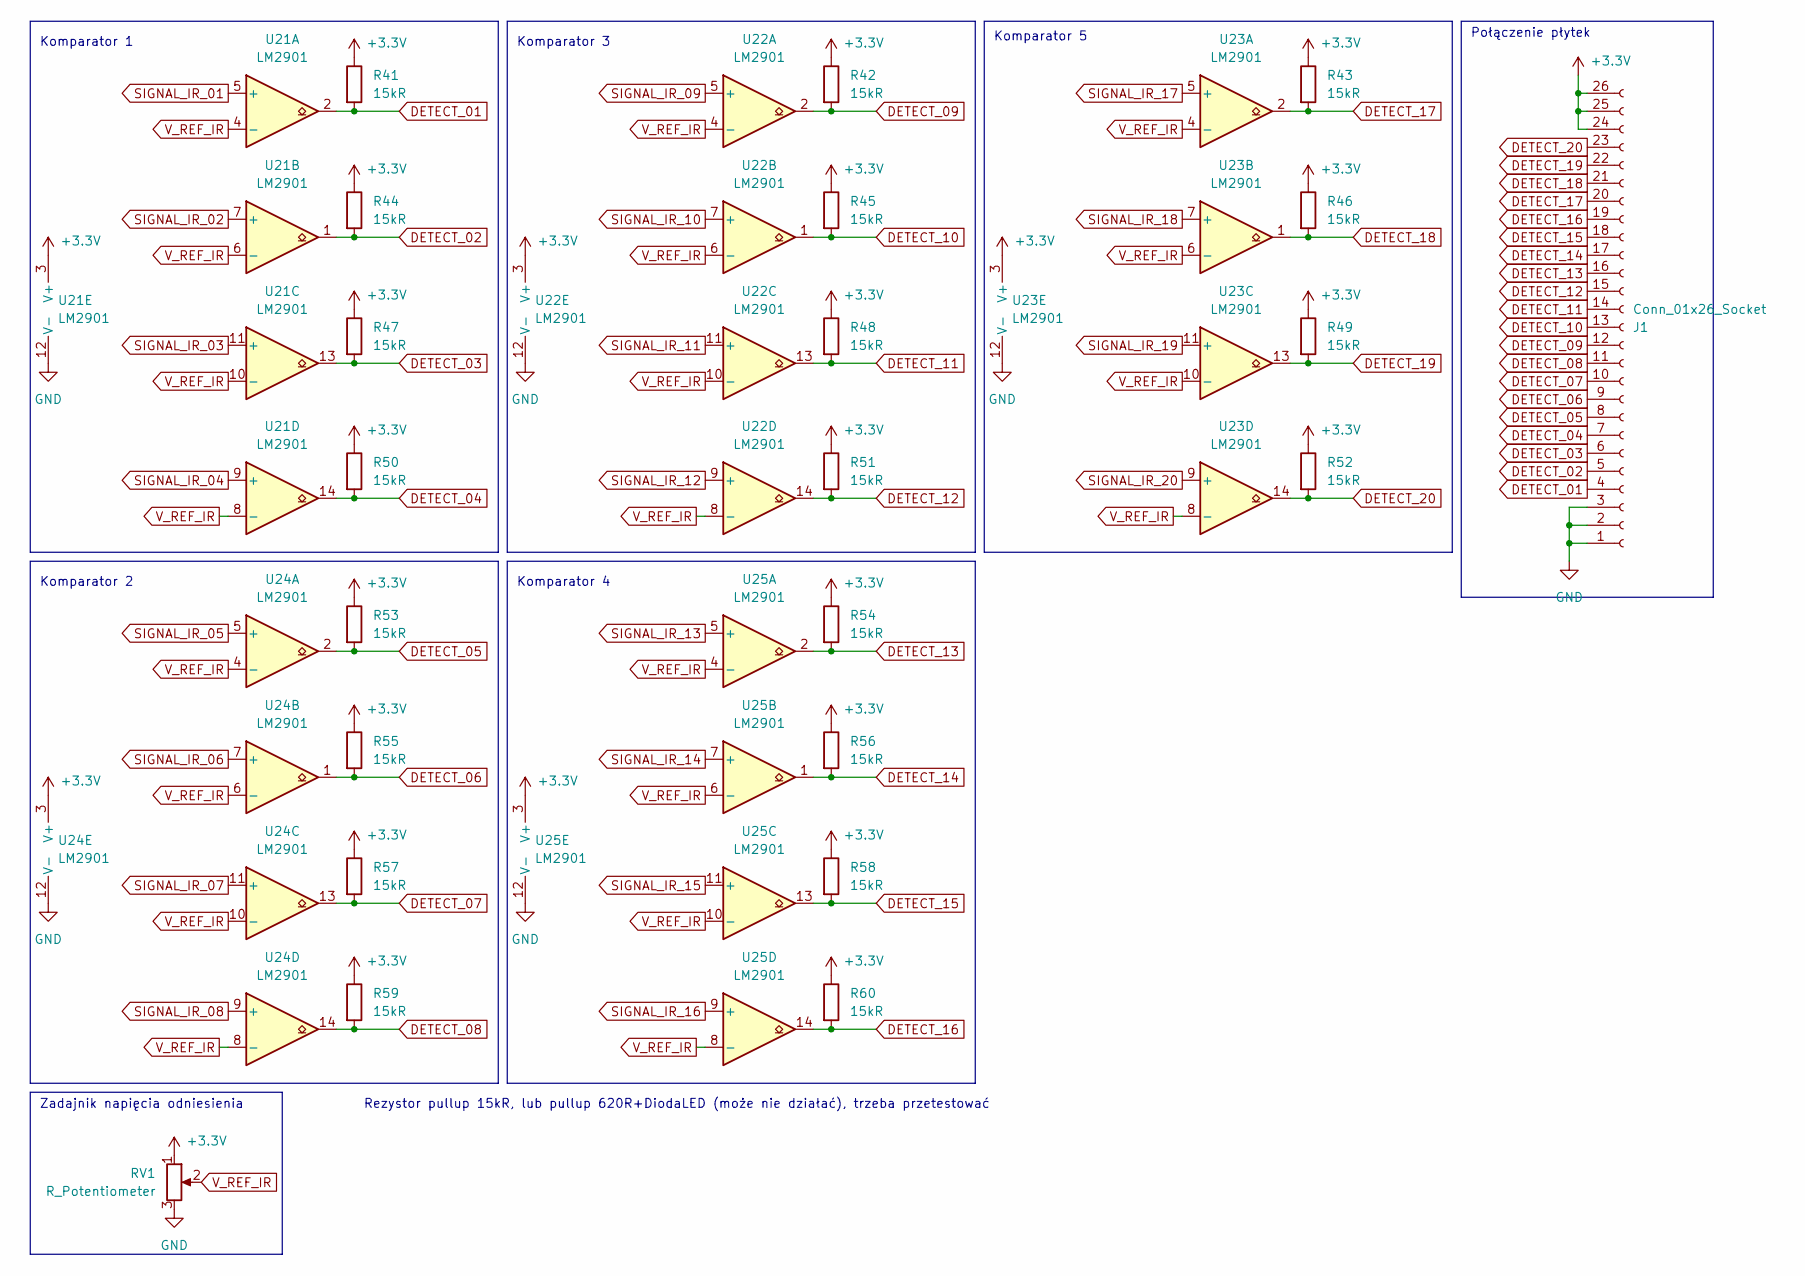
[picture p59: schematic komparatory.kicad_sch, Płytka z czujnikami]

Parts:
J1: Conn_01x26_Socket; Molex_200528-0260_1x26-1MP_P1.00mm_Horizontal
R41, R42, R43, R44, R45, R46, R47, R48, R49, R50, R51, R52, R53, R54, R55, R56, R57, R58, R59, R60: 15kR; R_0402_1005Metric_Pad0.72x0.64mm_HandSolder
RV1: R_Potentiometer; Potentiometer_Vishay_TS53YJ_Vertical
U21, U22, U23, U24, U25: LM2901; SO-14_5.3x10.2mm_P1.27mm

Connections:
+3.3V: J1.24, J1.25, J1.26, R41.1, R42.1, R43.1, R44.1, R45.1, R46.1, R47.1, R48.1, R49.1, R50.1, R51.1, R52.1, R53.1, R54.1, R55.1, R56.1, R57.1, R58.1, R59.1, R60.1, RV1.1, U21.3 (V+), U22.3 (V+), U23.3 (V+), U24.3 (V+), U25.3 (V+); also elsewhere on the board
DETECT_01: J1.4, R41.2, U21.2
DETECT_02: J1.5, R44.2, U21.1
DETECT_03: J1.6, R47.2, U21.13
DETECT_04: J1.7, R50.2, U21.14
DETECT_05: J1.8, R53.2, U24.2
DETECT_06: J1.9, R55.2, U24.1
DETECT_07: J1.10, R57.2, U24.13
DETECT_08: J1.11, R59.2, U24.14
DETECT_09: J1.12, R42.2, U22.2
DETECT_10: J1.13, R45.2, U22.1
DETECT_11: J1.14, R48.2, U22.13
DETECT_12: J1.15, R51.2, U22.14
DETECT_13: J1.16, R54.2, U25.2
DETECT_14: J1.17, R56.2, U25.1
DETECT_15: J1.18, R58.2, U25.13
DETECT_16: J1.19, R60.2, U25.14
DETECT_17: J1.20, R43.2, U23.2
DETECT_18: J1.21, R46.2, U23.1
DETECT_19: J1.22, R49.2, U23.13
DETECT_20: J1.23, R52.2, U23.14
GND: J1.1, J1.2, J1.3, RV1.3, U21.12 (V-), U22.12 (V-), U23.12 (V-), U24.12 (V-), U25.12 (V-); also elsewhere on the board
SIGNAL_IR_01: U21.5 (+); also elsewhere on the board
SIGNAL_IR_02: U21.7 (+); also elsewhere on the board
SIGNAL_IR_03: U21.11 (+); also elsewhere on the board
SIGNAL_IR_04: U21.9 (+); also elsewhere on the board
SIGNAL_IR_05: U24.5 (+); also elsewhere on the board
SIGNAL_IR_06: U24.7 (+); also elsewhere on the board
SIGNAL_IR_07: U24.11 (+); also elsewhere on the board
SIGNAL_IR_08: U24.9 (+); also elsewhere on the board
SIGNAL_IR_09: U22.5 (+); also elsewhere on the board
SIGNAL_IR_10: U22.7 (+); also elsewhere on the board
SIGNAL_IR_11: U22.11 (+); also elsewhere on the board
SIGNAL_IR_12: U22.9 (+); also elsewhere on the board
SIGNAL_IR_13: U25.5 (+); also elsewhere on the board
SIGNAL_IR_14: U25.7 (+); also elsewhere on the board
SIGNAL_IR_15: U25.11 (+); also elsewhere on the board
SIGNAL_IR_16: U25.9 (+); also elsewhere on the board
SIGNAL_IR_17: U23.5 (+); also elsewhere on the board
SIGNAL_IR_18: U23.7 (+); also elsewhere on the board
SIGNAL_IR_19: U23.11 (+); also elsewhere on the board
SIGNAL_IR_20: U23.9 (+); also elsewhere on the board
V_REF_IR: RV1.2, U21.4 (-), U21.6 (-), U21.8 (-), U21.10 (-), U22.4 (-), U22.6 (-), U22.8 (-), U22.10 (-), U23.4 (-), U23.6 (-), U23.8 (-), U23.10 (-), U24.4 (-), U24.6 (-), U24.8 (-), U24.10 (-), U25.4 (-), U25.6 (-), U25.8 (-), U25.10 (-)

Notes on the sheet:
Komparator 1
Połączenie płytek
Komparator 4
Komparator 3
Zadajnik napięcia odniesienia
Komparator 2
Komparator 5
Rezystor pullup 15kR, lub pullup 620R+DiodaLED (może nie działać), trzeba przetestować

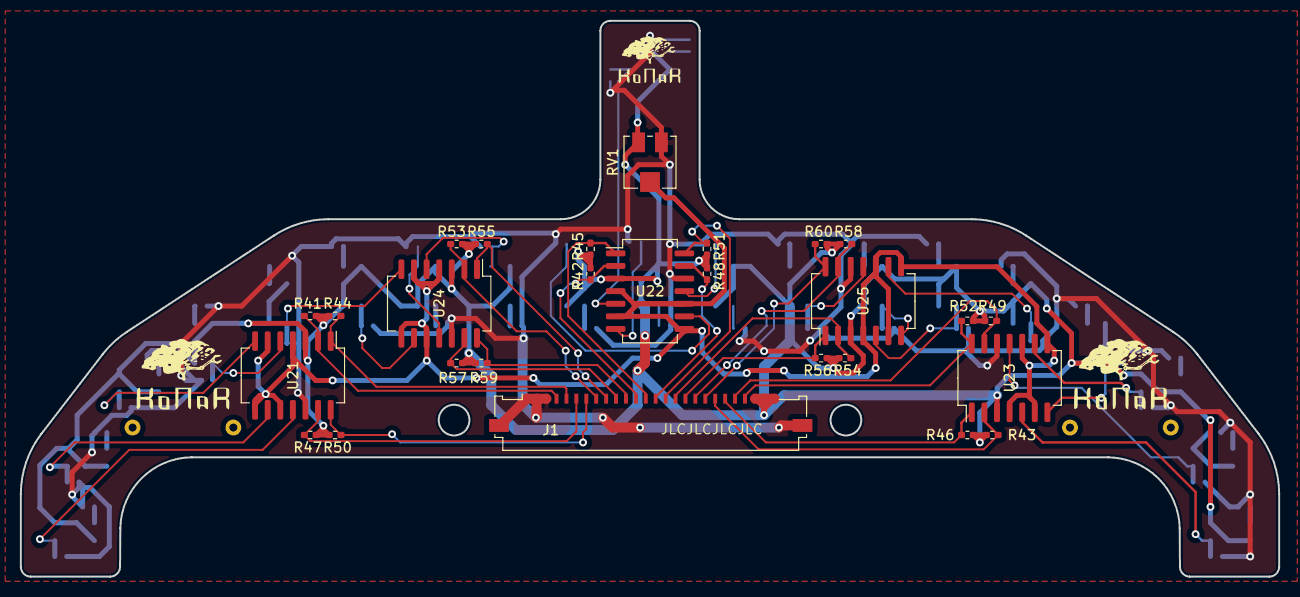
[picture p60: board Płytka z czujnikami.kicad_pcb from above]

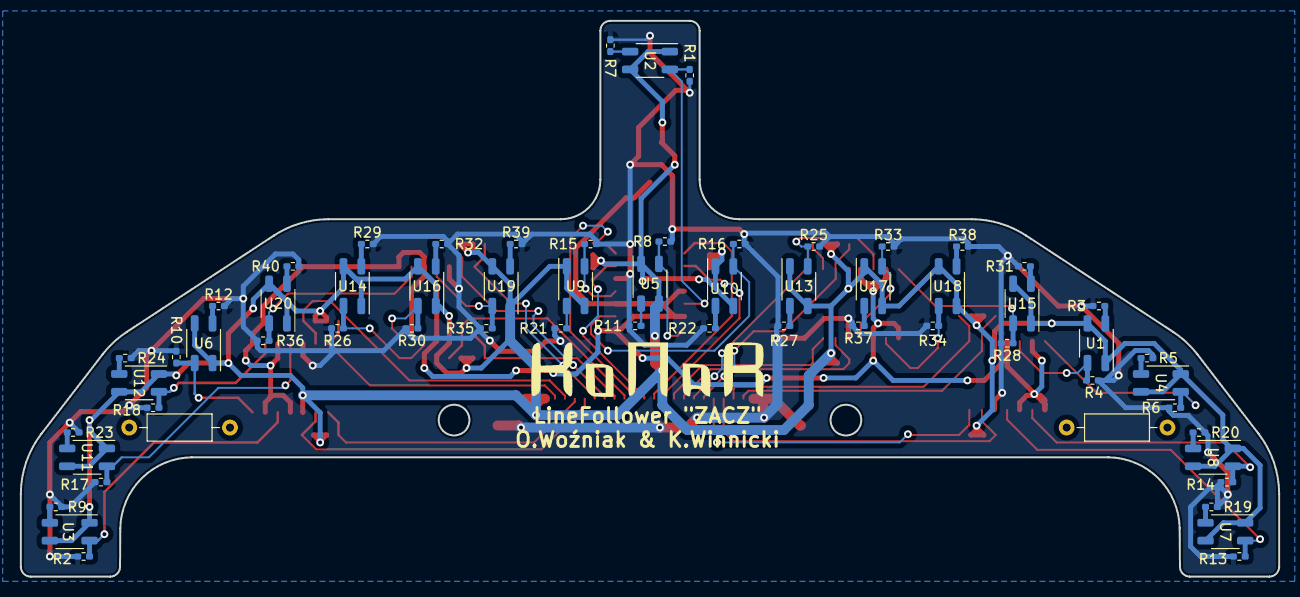
[picture p61: board Płytka z czujnikami.kicad_pcb from below]

Board: 2 copper layers, 126.8 x 56.0 mm, 89 parts (62 on the bottom side), 63 nets.
