KamilWuu/Line_Follower_ZACZ/electronics/Płytka główna/Płytka główna.kicad_pcb

## KiCad design electronics/Płytka główna/Płytka główna.kicad_pcb (2024-05-05)

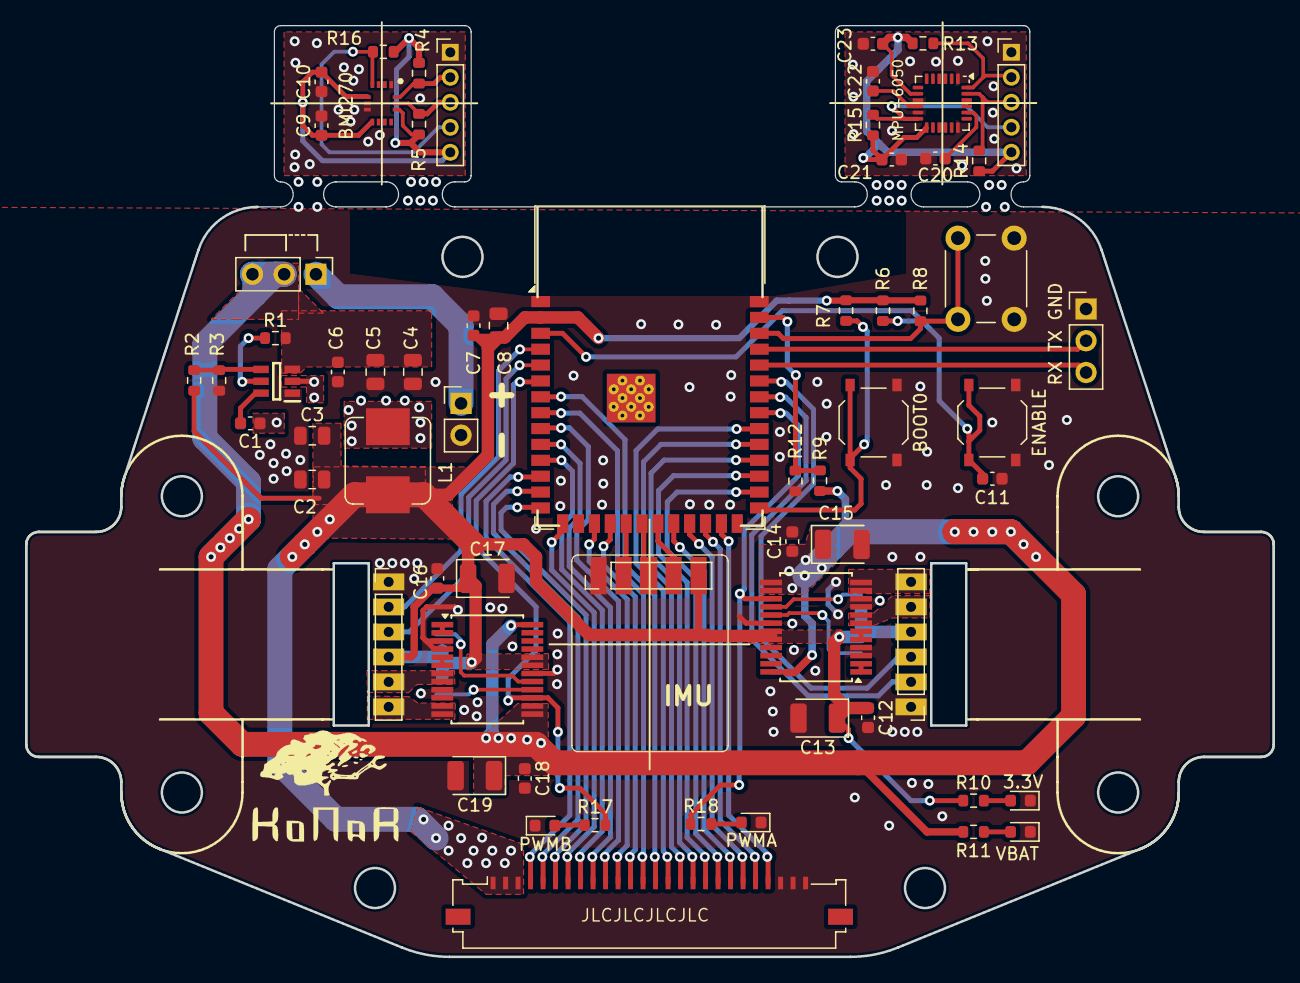
[picture p62: board Płytka główna.kicad_pcb from above]

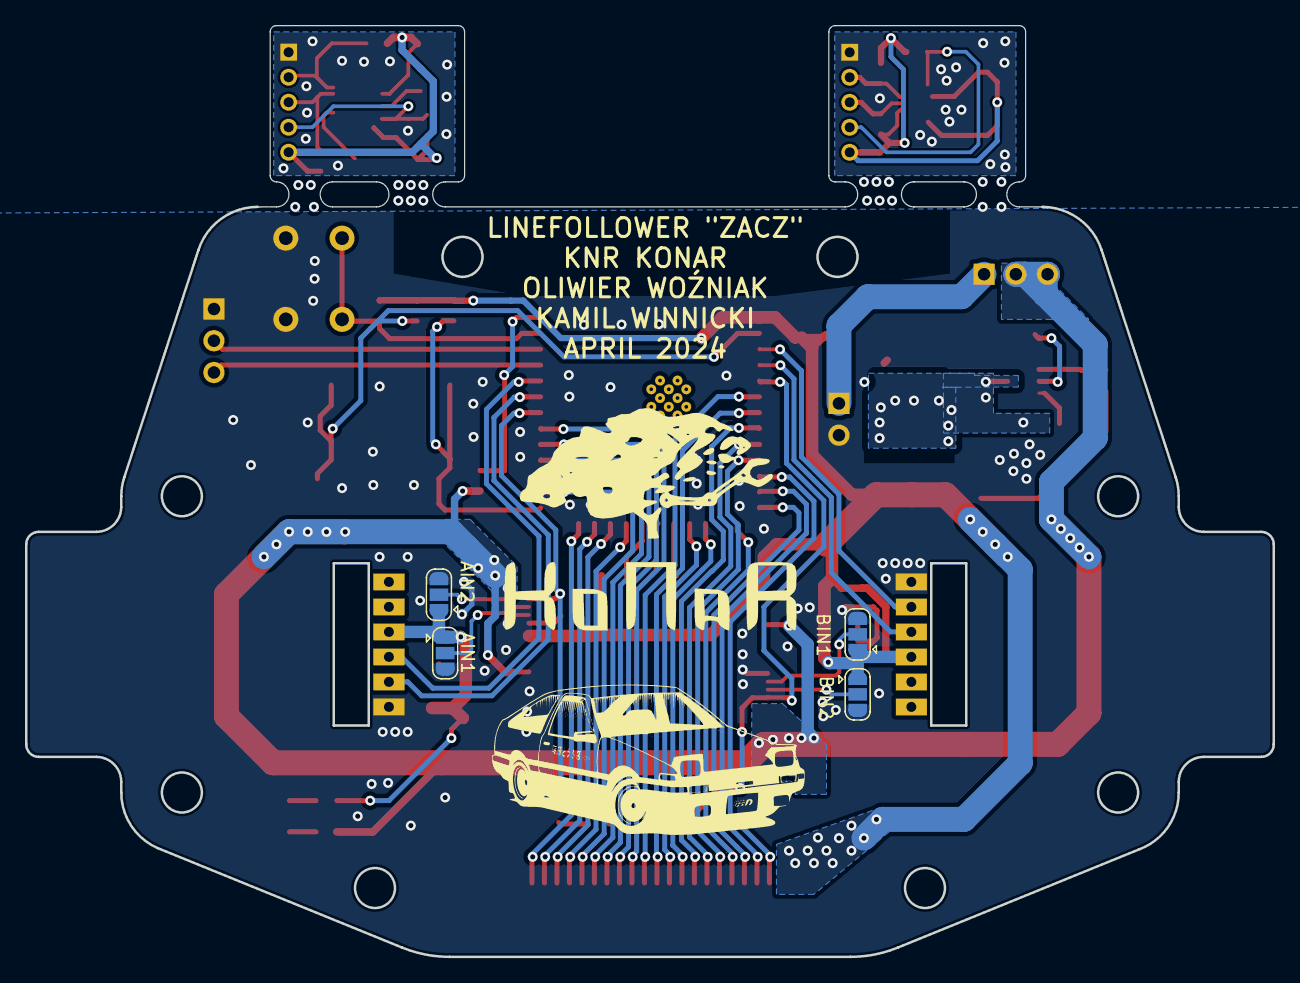
[picture p63: board Płytka główna.kicad_pcb from below]

Board: 2 copper layers, 99.8 x 74.5 mm, 68 parts (4 on the bottom side), 71 nets.

Parts:
3.3V: LED; LED_0603_1608Metric
AIN1, AIN2: SolderJumper_3_Open; SolderJumper-3_P1.3mm_Open_RoundedPad1.0x1.5mm
BIN1, BIN2: SolderJumper_3_Open; SolderJumper-3_P1.3mm_Open_RoundedPad1.0x1.5mm
BOOT0: SW_Push_Dual_x2; SW_Push_1P1T_XKB_TS-1187A
C1, C6, C7, C9, C10, C11, C12, C14, C16, C18, C21, C22: 0.1uF; C_0603_1608Metric
C2, C3, C8: 22uF; C_0805_2012Metric
C4, C5: 10uF; C_0805_2012Metric
C13, C17: >10uF/3.3V; CP_EIA-3528-21_Kemet-B
C15, C19: >10uF/8.4V; CP_EIA-3528-21_Kemet-B
C20: 2.2nF; C_0603_1608Metric
C23: 10nF; C_0603_1608Metric
ENABLE: SW_Push_Dual_x2; SW_Push_1P1T_XKB_TS-1187A
IC1: TPS563201DDCR; SOT95P280X110-6N
IC2: BMI270; QFN50P300X250X87-14N
J2: Conn_01x26_Socket; Molex_200528-0260_1x26-1MP_P1.00mm_Horizontal
J3, J4: Conn_01x06_Socket; PinHeader_1x06_P2.00mm_Vertical
J5: battery_connector; PinHeader_1x02_P2.54mm_Vertical
J6: Conn_01x03_Pin; PinHeader_1x03_P2.54mm_Vertical
J7: batt_switch; PinHeader_1x03_P2.54mm_Vertical
J8, J9, J10: Conn_01x05_Pin; PinHeader_1x05_P2.00mm_Vertical
L1: 2.2uH; L_Bourns_SRP7028A_7.3x6.6mm
MPU-6050: MPU-6050; InvenSense_QFN-24_4x4mm_P0.5mm
PWMA: LED; LED_0603_1608Metric
PWMB: LED; LED_0603_1608Metric
R1, R3: 10kR; R_0603_1608Metric
R2: 33.2kR; R_0603_1608Metric
R4, R5, R6, R7, R8, R13, R14, R15, R16: 10K; R_0603_1608Metric
R9, R12: ?; R_0603_1608Metric
R10: 220; R_0603_1608Metric
R11, R17, R18: 2K; R_0603_1608Metric
SW4: SW_Push_Dual_x2; SW_PUSH_6mm_H7.3mm
U1: ESP32-S3-WROOM-1-N8R8; ESP32-S3-WROOM-1
U2, U3: TB6612FNG; SSOP-24_5.3x8.2mm_P0.65mm
VBAT: LED; LED_0603_1608Metric

Connections:
+3.3V: AIN1.1 (A), AIN2.1 (A), BIN1.1 (A), BIN2.1 (A), C2.2, C3.2, C7.2, C8.2, C12.1, C13.1, C16.1, C17.1, J2.1, J2.2, J2.3, J3.4, J4.4, J9.5, L1.1, R2.2, R6.1, R7.1, R8.1, R10.1, U1.2 (3V3), U2.19 (STBY), U2.20 (VCC), U3.19 (STBY), U3.20 (VCC)
+3.3V_BMI: C9.1, C10.2, IC2.5 (VDDIO), IC2.8 (VDD), IC2.12 (CSB), J10.5, R4.1, R5.1, R16.1
+3.3V_MPU: C21.2, C23.2, J8.5, MPU-6050.8 (VLOGIC), MPU-6050.13 (VDD), R13.1, R14.1, R15.1
+BATT: C4.1, C5.1, C6.1, C14.1, C15.1, C18.1, C19.1, IC1.3 (VIN), J7.2, J7.3, R1.2, R9.1, R11.1, U2.13 (VM2), U2.14 (VM3), U2.24 (VM1), U3.13 (VM2), U3.14 (VM3), U3.24 (VM1)
AIN1: AIN1.2 (C), U2.17 (BIN1)
AIN2: AIN2.2 (C), U2.16 (BIN2)
AO1: J3.6, U2.11 (BO1), U2.12 (BO1)
AO2: J3.5, U2.7 (BO2), U2.8 (BO2)
BIN1: BIN1.2 (C), U3.17 (BIN1)
BIN2: BIN2.2 (C), U3.16 (BIN2)
BO1: J4.6, U3.11 (BO1), U3.12 (BO1)
BO2: J4.5, U3.7 (BO2), U3.8 (BO2)
BUTTON: R8.2, SW4.2 (D), U1.38 (IO2)
EN: C11.2, ENABLE.2 (D), R6.2, U1.3 (EN)
ENC_A1: J3.3, U1.35 (IO42)
ENC_A2: J3.2, U1.34 (IO41)
ENC_B1: J4.3, U1.5 (IO5)
ENC_B2: J4.2, U1.4 (IO4)
GND: 3.3V.1 (K), AIN1.3 (B), AIN2.3 (B), BIN1.3 (B), BIN2.3 (B), BOOT0.1 (C), C2.1, C3.1, C4.2, C5.2, C6.2, C7.1, C8.1, C11.1, C12.2, C13.2, C14.2, C15.2, C16.2, C17.2, C18.2, C19.2, ENABLE.1 (C), IC1.1 (GND), J2.24, J2.25, J2.26, J3.1, J4.1, J5.2, J6.1, J9.1, PWMA.1 (K), PWMB.1 (K), R3.1, R12.2, SW4.1 (C), U1.1 (GND), U1.40 (GND), U2.3 (PGND1), U2.4 (PGND1), U2.9 (PGND2), U2.10 (PGND2), U2.18 (GND), U3.3 (PGND1), U3.4 (PGND1), U3.9 (PGND2), U3.10 (PGND2), U3.18 (GND), VBAT.1 (K)
GND_BMI: C9.2, C10.1, IC2.1 (SDO), IC2.6 (GNDIO), IC2.7 (GND), J10.1
GND_MPU: C20.1, C21.1, C22.2, C23.1, J8.1, MPU-6050.1 (CLKIN), MPU-6050.9 (AD0), MPU-6050.11 (FSYNC), MPU-6050.18 (GND)
IMU_INT: J9.4, U1.21 (IO13)
INT_BMI: IC2.4 (INT1), J10.4, R16.2
INT_MPU: J8.4, MPU-6050.12 (INT), R15.2
IO0: BOOT0.2 (D), R7.2, U1.27 (IO0)
IR_SIG_01: J2.4, U1.12 (IO8)
IR_SIG_02: J2.5, U1.13 (IO19)
IR_SIG_03: J2.6, U1.14 (IO20)
IR_SIG_04: J2.7, U1.15 (IO3)
IR_SIG_05: J2.8, U1.11 (IO18)
IR_SIG_06: J2.9, U1.10 (IO17)
IR_SIG_07: J2.10, U1.9 (IO16)
IR_SIG_08: J2.11, U1.17 (IO9)
IR_SIG_09: J2.12, U1.18 (IO10)
IR_SIG_10: J2.13, U1.8 (IO15)
IR_SIG_11: J2.14, U1.7 (IO7)
IR_SIG_12: J2.15, U1.32 (IO39)
IR_SIG_13: J2.16, U1.31 (IO38)
IR_SIG_14: J2.17, U1.30 (IO37)
IR_SIG_15: J2.18, U1.29 (IO36)
IR_SIG_16: J2.19, U1.28 (IO35)
IR_SIG_17: J2.20, U1.22 (IO14)
IR_SIG_18: J2.21, U1.23 (IO21)
IR_SIG_19: J2.22, U1.24 (IO47)
IR_SIG_20: J2.23, U1.25 (IO48)
unnamed: 3.3V.2 (A), R10.2
unnamed: IC1.5 (EN), R1.1
unnamed: C1.2, IC1.6 (VBST)
unnamed: IC1.4 (VFB), R2.1, R3.2
unnamed: J5.1, J7.1
unnamed: C20.2, MPU-6050.20 (CPOUT)
unnamed: C22.1, MPU-6050.10 (REGOUT)
unnamed: PWMA.2 (A), R18.2
unnamed: PWMB.2 (A), R17.2
unnamed: U2.1 (AO1), U2.2 (AO1)
unnamed: U2.5 (AO2), U2.6 (AO2)
unnamed: U3.1 (AO1), U3.2 (AO1)
unnamed: U3.5 (AO2), U3.6 (AO2)
unnamed: R11.2, VBAT.2 (A)
PWMA: R18.1, U1.33 (IO40), U2.15 (PWMB)
PWMB: R17.1, U1.6 (IO6), U3.15 (PWMB)
RX: J6.3, U1.36 (RXD0)
SCL_I2C: J9.3, U1.20 (IO12)
SCL_I2C_BMI: IC2.13 (SCX), J10.3, R5.2
SCL_I2C_MPU: J8.3, MPU-6050.23 (SCL), R14.2
SDA_I2C: J9.2, U1.19 (IO11)
SDA_I2C_BMI: IC2.14 (SDX), J10.2, R4.2
SDA_I2C_MPU: J8.2, MPU-6050.24 (SDA), R13.2
SW: C1.1, IC1.2 (SW), L1.2
TX: J6.2, U1.37 (TXD0)
V_BAT: R9.2, R12.1, U1.39 (IO1)
