KamilWuu/Line_Follower_ZACZ/zacz_code/include/Sensors.h

#ifndef SENSORS_H
#define SENSORS_H

#include <Arduino.h>

/**
 * PRZYJMUJEMY ZE ODCZYT 1 OZNACZA ZNALEZIENIE LINI W SENSIE ZE CZUJNIK WYKRYWA CZARNE JESLI BEDZIE INACZEJ TO ZROBIMY NEGACJE ZEBY ZAWSZE 1 OZNACZALO ZNALEZIENIE LINI
*/

class Sensors{
private:
    /*trzeba ustawic piny tak aby odpowiadaly one rzeczywistym czujnikom od lewej strony, a ten jeden przedni jako ostatni*/
    const uint8_t IR_SENSORS_PINS[20] = {21,14,47,48,36,38,37,35,10,7,15,17,16,9,18,20,8,19,3,39};  
    //Już odpowiadają // Tymczasowo czujnik jest wyłączony
    const int8_t SENSORS_WEIGHTS[20] = {-9,-8,-7,-6,-5,-4,-3,-2,-1,0,1,2,3,4,5,6,7,8,9,0}; /*PID WEIGHTS*/
    uint8_t measures[20];
    uint8_t last_measures[20];
    int16_t sensors_error;
public:
    Sensors();
    int16_t readSensors();
    const uint8_t * getSensorsPins();
    uint8_t * getSensorsMeasures();
    void printSensorsMeasures();
    uint16_t getSensorsError();
};


#endif 
