KamilWuu/Line_Follower_ZACZ/zacz_code/include/ReceivedData.h

#ifndef RECEIVEDDATA_H
#define RECEIVEDDATA_H

#include <Arduino.h>

enum pidParameter{
    K_P,
    K_I,
    K_D
};

class ReceivedData {
private:
    String debugString;
    char instruction;
    uint16_t PID_P;
    uint16_t PID_I;
    uint16_t PID_D;
    uint8_t V_MAX;

 
public:
    ReceivedData();
    void setData(String data);
    void displayData(HardwareSerial * serial);
    char getInstruction();
    uint8_t getVMax();
    String getString();
    uint16_t getPID_parameter(enum pidParameter param);
    void setInstruction(char ins);

};



//$Mx123x456x789x1000#
#endif
