KamilWuu/Line_Follower_ZACZ/(commit log)

2024-03-31 start repository
    [A4.ipt, ESP32-S3-WROOM-1.ipt, LF.iam, LF_1.kicad_pcb, LF_1.kicad_sch, LF_2.0003.iam, LF_2.iam, QRE1113GR.ipt]
2024-03-31 ESP and H-Bridge scheme
    [LF_1.kicad_sch]
2024-03-31 some changes in electronics
    [LF_1.kicad_pcb, LF_1.kicad_sch, LF_2.0003.iam, LF_2.0004.iam, LF_2.iam, back_PCB_draw.dxf, n20_bracket.ipt, n20_bracket.step]
2024-04-03 Podzielono schematy, dodano footprinty
    [LF_1.kicad_pcb, LF_1.kicad_sch, czujniki_podłoża.kicad_sch, esp_32.kicad_sch, mostki_h.kicad_sch, zasilanie.kicad_sch]
2024-04-03 Dodanie zasilania baterii
    [zasilanie.kicad_sch]
2024-04-03 Dodanie zasialnia 3.3V
    [zasilanie.kicad_sch]
2024-04-03 Dodano czujniki odbiciowe
    [czujniki_podłoża.kicad_sch]
2024-04-04 Poprawienie estetyki schematów
    [LF_1.kicad_sch, czujniki_podłoża.kicad_sch, esp_32.kicad_sch, mostki_h.kicad_sch, zasilanie.kicad_sch]
2024-04-04 Dodanie IMU
2024-04-09 Podłączenie IMU i poprawa estetyki
    [czujniki_podłoża.kicad_sch, esp_32.kicad_sch, komparatory.kicad_sch]
2024-04-10 Dodano podział na płytkę przednią i główną
    [Płytka główna.kicad_pcb, Płytka główna.kicad_sch, Płytka z czujnikami.kicad_pcb, Płytka z czujnikami.kicad_sch, czujniki1.kicad_sch, esp32.kicad_sch, komparatory.kicad_sch, mostki_h.kicad_sch]
2024-04-10 Zakończono pracę nad układem przedniej płytki
    [Płytka z czujnikami.kicad_pcb, czujniki1.kicad_sch, komparatory.kicad_sch, łączenie.kicad_sch]
2024-04-10 Niewielkie zmiany w w układzie głównej płytki
    [esp32.kicad_sch, mostki_h.kicad_sch, zasilanie.kicad_sch]
2024-04-10 Schematy ideowe ukończone
    Do edycji pozostają jedynie ledy sygnalizacyjne, oraz footprinty od przycisków
    [esp32.kicad_sch, mostki_h.kicad_sch, zasilanie.kicad_sch]
2024-04-23 pierwsze prace nad glowna plytka
    [LF_2.0004.iam, LF_2.0005.iam, LF_2.iam, N20_Bracket_Extended_Pololu.0001.ipt, N20_Bracket_Extended_Pololu.ipt, N20_Bracket_Extended_Pololu.stp, Płytka główna.kicad_pcb, Płytka główna.kicad_sch]
2024-04-24 drobne zmianmy w mechanice
    [LF_2.0005.iam, LF_2.0009.iam, LF_2.iam, lacznik.0004.ipt, lacznik.ipt, plytka_glowna.0001.ipt, plytka_glowna.dxf, plytka_glowna.ipt]
2024-04-27 Rozpoczęto pracę nad przednią płytką
    [Płytka z czujnikami.kicad_pcb, czujniki1.kicad_sch, esp32.kicad_sch, komparatory.kicad_sch, sensor_board.dxf]
2024-04-28 rozpoczeto prace nad plytka glowna
    [LF_2.0009.iam, LF_2.0011.iam, LF_2.iam, Płytka główna.kicad_pcb, esp32.kicad_sch, main_board_limits.dxf, main_board_v3.dxf, mostki_h.kicad_sch]
2024-04-29 layout plytki glownej
    [Płytka główna.kicad_pcb, esp32.kicad_sch, mostki_h.kicad_sch]
2024-04-29 Poprawa wymiarów płytki przedniej, oraz wstępne uporządkowanie ułożenia elementów
    [Płytka z czujnikami.kicad_pcb, Płytka z czujnikami.kicad_sch, czujniki1.kicad_sch, komparatory.kicad_sch, przód V2.0.0001.ipt, przód V2.0.ipt, sensor_board_V2.0.dxf]
2024-05-01 zmieniono pinout na zlaczu ffc
    [LF_2.0011.iam, LF_2.0012.iam, LF_2.iam, Płytka główna.kicad_pcb, Płytka z czujnikami.kicad_pcb, esp32.kicad_sch, komparatory.kicad_sch, plytka_glowna.0003.ipt]
2024-05-01 dodatkowe plytki do IMU
    [Płytka główna.kicad_pcb, esp32.kicad_sch, zasilanie.kicad_sch]
2024-05-01 ukonczono glowna plytke
    [Płytka główna.kicad_pcb, esp32.kicad_sch]
2024-05-02 Ukończono płytkę z czujnikami
    [Płytka z czujnikami.kicad_pcb]
2024-05-03 Odwrócono zasilanie w płytce z czujnikami
    [Płytka z czujnikami.kicad_pcb, komparatory.kicad_sch]
2024-05-04 ostatnie poprawki
    [Płytka główna.kicad_pcb, esp32.kicad_sch]
2024-05-04 plytki gotowe do produkcji
    [Płytka główna.kicad_pcb, Płytka z czujnikami.kicad_pcb]
2024-05-04 drobne poprawki 2
    [Płytka główna.kicad_pcb, Płytka z czujnikami.kicad_pcb, czujniki1.kicad_sch]
2024-05-05 plytka glowna gotowa do produkcji
    [Płytka główna.kicad_pcb, esp32.kicad_sch]
2024-05-05 ostatnia poprawa plytki przed profukcja
    [Płytka główna.kicad_pcb, esp32.kicad_sch]
2024-05-25 added defines and IR sensors class
2024-05-25 added pid weights for IR sensors
2024-05-26 Poprawione wypisywanie sensorów, dokonano dodatkowych testów.
2024-06-05 Napisano poprawny PID, to znaczy działa tylko PD, ale nie sparwdzałem
2024-06-06 W miarę poprawnie diałający PID, trzeba wykonać więcej testów i sprawdzić optymalne nastawy
2024-06-06 Dodano pliki do sprawka
    [Płytka główna.kicad_sch, Płytka z czujnikami.kicad_sch, czujniki1.kicad_sch, esp32.kicad_sch, komparatory.kicad_sch, mostki_h.kicad_sch, zasilanie.kicad_sch]
2024-06-22 dodano dokumentacje III etapu
    [LF_2.0012.iam, LF_2.0014.iam, LF_2.iam, N20_Bracket_Extended_Pololu.0001.ipt, N20_Bracket_Extended_Pololu.0002.ipt, N20_Bracket_Extended_Pololu.ipt, Płytka główna.step, Płytka z czujnikami.kicad_pcb]
